Eduzyolo/PSE_project/SCHEMATIC/scheda PSE/libreria/3dmodels/DG126-5.0-xxP (pitch 5.0mm)/Demo-DG126.png

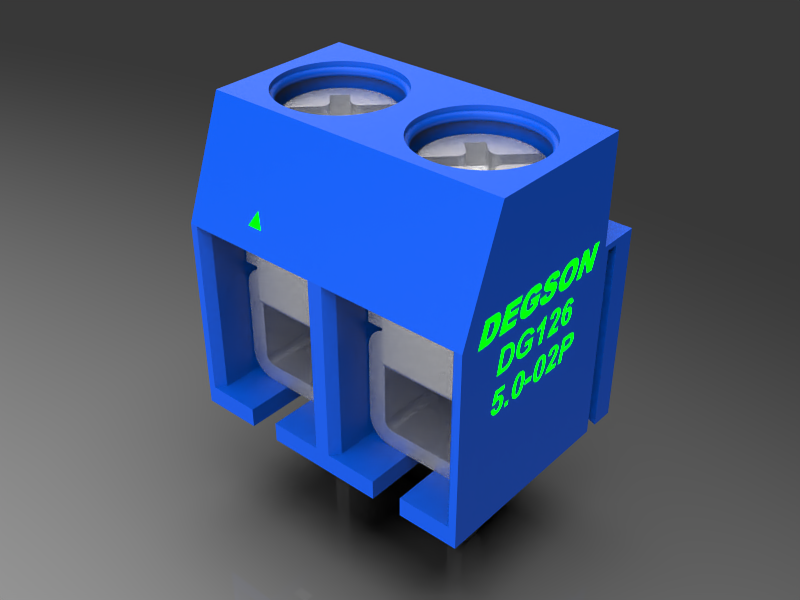
SCHEMATIC/scheda PSE/libreria/3dmodels/DG126-5.0-xxP (pitch 5.0mm)/Demo-DG126.png
