Eduzyolo/PSE_project/CASE/render/immagini scheda/immagine case_Gloss.png

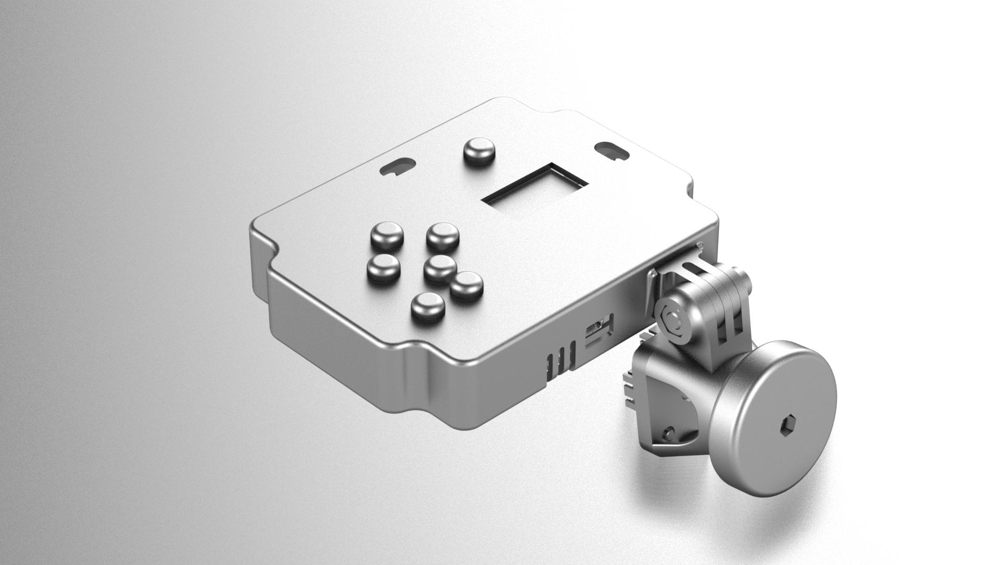
CASE/render/immagini scheda/immagine case_Gloss.png
