Eduzyolo/PSE_project/README.md

# PSE_project
This is the official repo for the PSE project 

# LICENSE
This repo is under CC BY-NC 4.0 license
