Eduzyolo/PSE_project/CASE/README.md

This folder contains the project for the CAD 3D
