Eduzyolo/PSE_project/CASE/stl per stampa del CASE e ENCODER/README.md

IMPOSTAZIONI E OGGETTI NECESSARI PER IL CASE
per un breve tutorial visitare la pagina:
https://floppylab.altervista.org/case-per-un-circuito/

IMPOSTAZIONI STAMPA (valide per tutte le parti):
 - materiale PLA
 - layer 0.2mm
 - riempimento 15%
 - 3 perimetri
 - skirt (facoltativo)
 - orientamento parte come da file
 - no supporti

 OGGETTI NECESSARI:
  - 1 vite M3 8mm (testa svasata)
  - 4 viti M3 10mm (testa svasata)
  - 7 viti M3 16mm (testa svasata)
  - molle Ø 4mm, Ø filo 0.2mm, lunghezza 5mm
  	- (quelle delle penne da scrivere vanno bene) -> da tagliare in pezzi lunghi 5mm circa
  - 5 inserti filettati in ottone M3 3mm
  - 30cm tubo in PVC trasparente Øext 6mm, Øint 4mm

OGGETTI FACOLTATIVI:
 - bomboletta spray nera (per l'interno del case)
 - bomboletta spray colore a scelta (per l'esterno del case)
