Eduzyolo/PSE_project/CASE/render/immagini scheda/immagine case.png

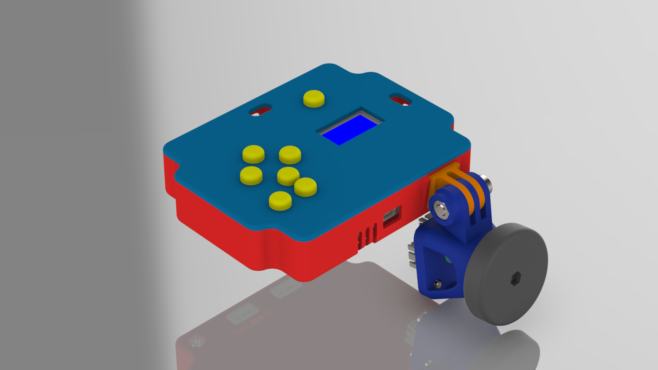
CASE/render/immagini scheda/immagine case.png
