Eduzyolo/PSE_project/CASE/render/immagini scheda/immagine case_Clown.png

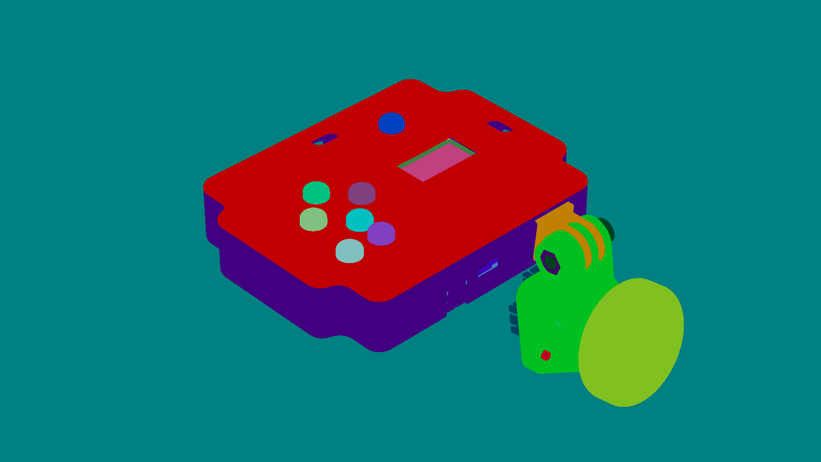
CASE/render/immagini scheda/immagine case_Clown.png
