Eduzyolo/PSE_project/CASE/render/immagini scheda/immagine case_Roughness.png

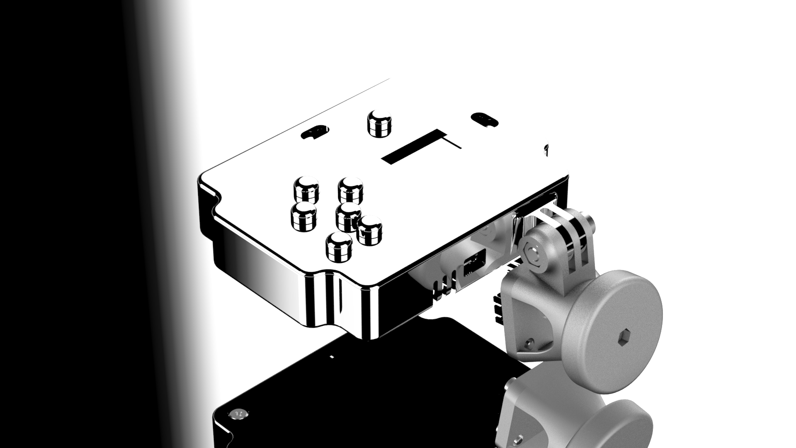
CASE/render/immagini scheda/immagine case_Roughness.png
