Eduzyolo/PSE_project/CASE/render/immagini scheda/render assieme esploso.JPG

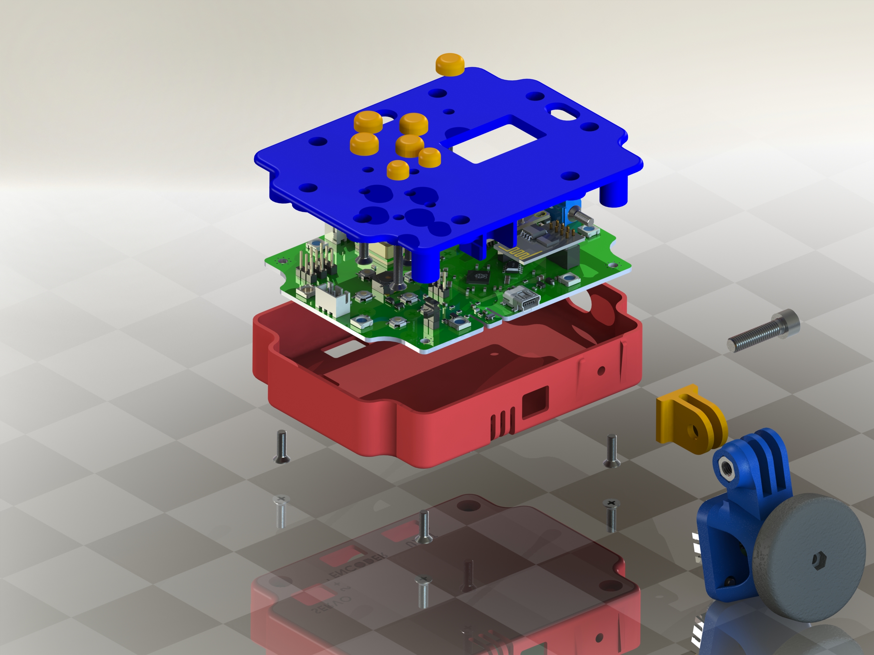
CASE/render/immagini scheda/render assieme esploso.JPG
