Eduzyolo/PSE_project/CASE/encoder magnetico/Assieme.SLDASM

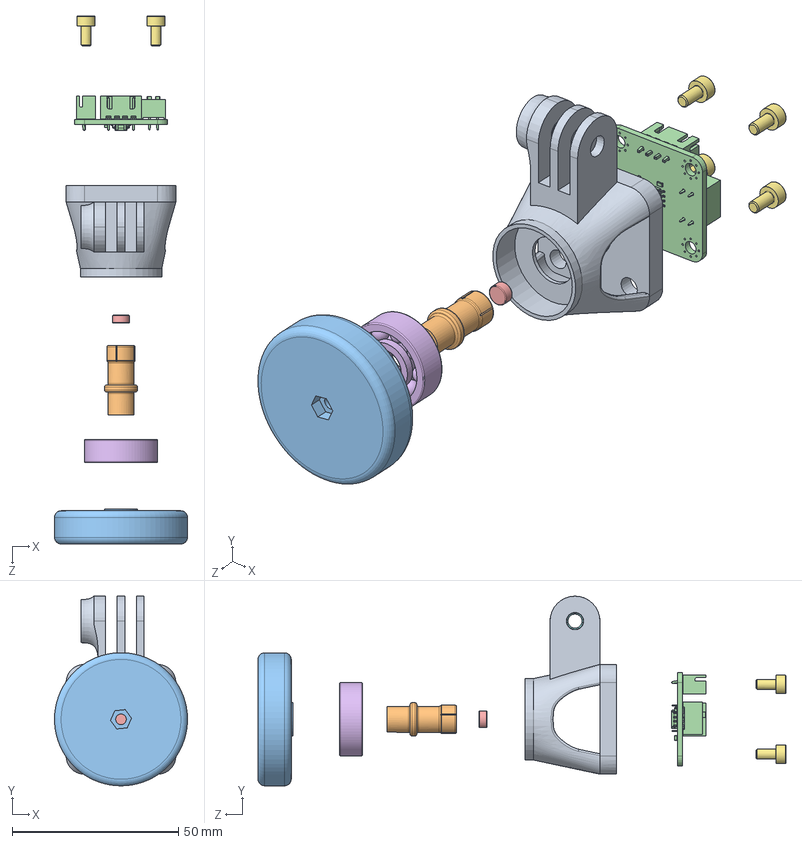
[picture p7: CAD file, 2023-06-22]
CASE/encoder magnetico/Assieme.SLDASM
40.0 x 57.0 x 158.7 mm
case encoder
perno sotto
ruota
PCB encoder
magnete
instrument ball bearing_68_iso
socket head cap screw_iso x 4
hex nut style 1 gradeab_iso
