Eduzyolo/PSE_project/CASE/case del prof/case grande PSE.dxf

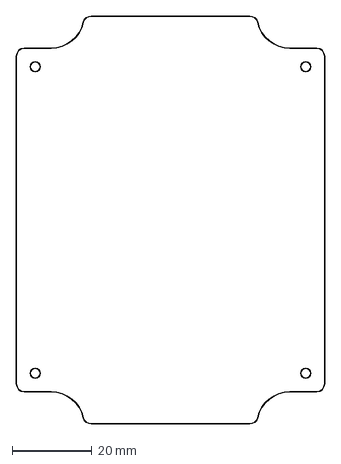
[picture p8: CAD file, 2023-04-04]
CASE/case del prof/case grande PSE.dxf
77.4 x 102.4 mm
