Eduzyolo/PSE_project/CASE/case scheda pse/coperchio.SLDPRT

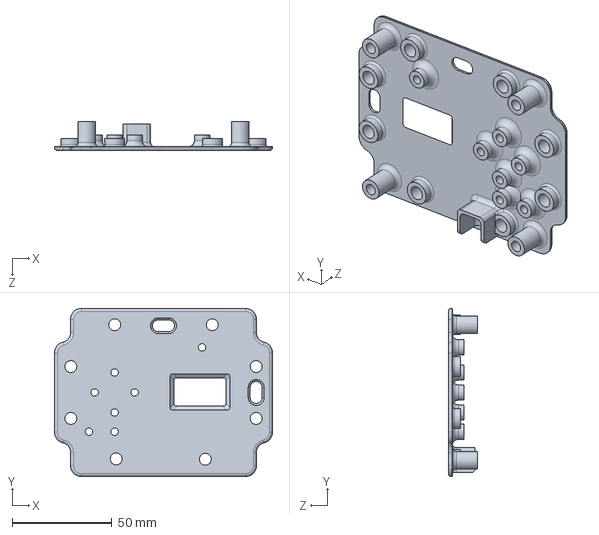
[picture p9: CAD file, 2023-06-22]
CASE/case scheda pse/coperchio.SLDPRT
109.4 x 84.4 x 14.8 mm
