Eduzyolo/PSE_project/CASE/case scheda pse/stl case e encoder/scheda PSE - attacco gopro senza vite.STL

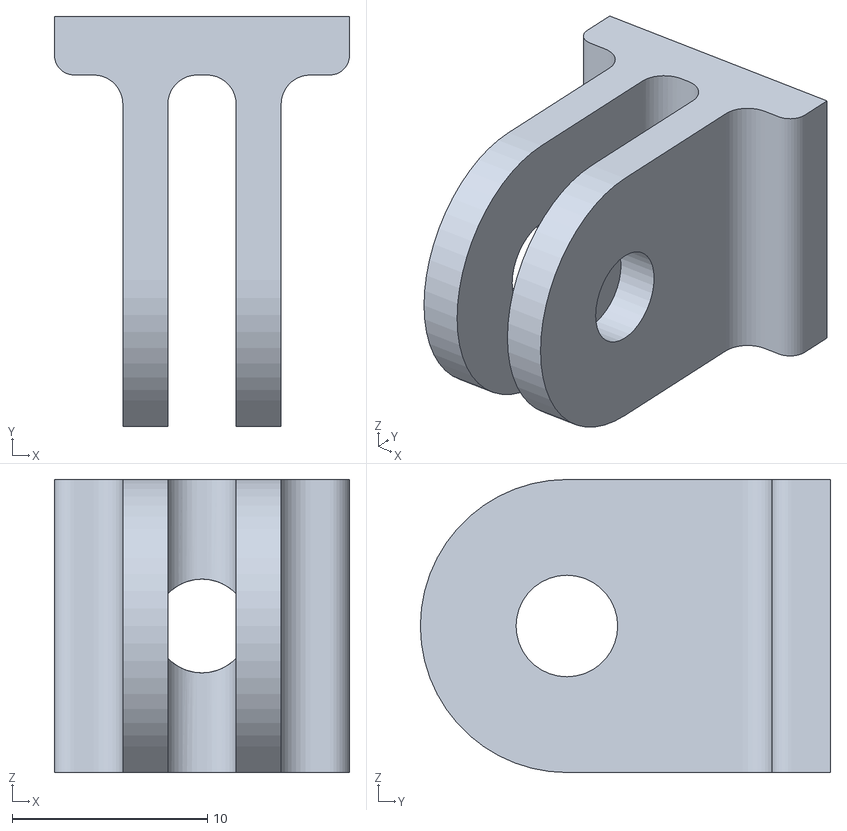
[picture p10: CAD file, 2023-06-18]
CASE/case scheda pse/stl case e encoder/scheda PSE - attacco gopro senza vite.STL
15.1 x 21.0 x 15.0
