Eduzyolo/PSE_project/CASE/stl per stampa del CASE e ENCODER/scheda PSE - bottoni 2.0.STL

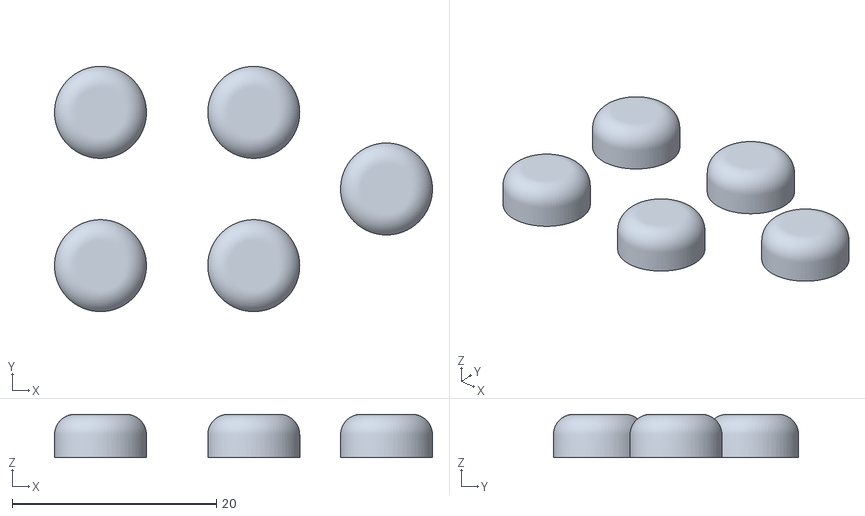
[picture p11: CAD file, 2023-06-18]
CASE/stl per stampa del CASE e ENCODER/scheda PSE - bottoni 2.0.STL
37.0 x 24.0 x 4.25
