Eduzyolo/PSE_project/SCHEMATIC/ENCODER/ENCODER.step

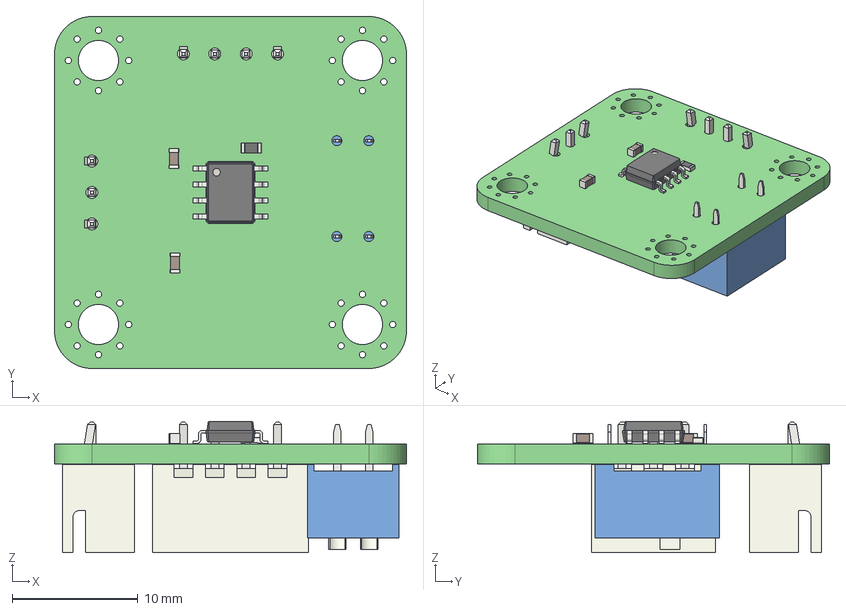
[picture p12: CAD file, 2023-04-01]
SCHEMATIC/ENCODER/ENCODER.step
28.0 x 28.0 x 10.4 mm
ENCODER PCB
