Eduzyolo/PSE_project/SCHEMATIC/scheda PSE/libreria/3dmodels/AKSCT-G-BLACK.stp

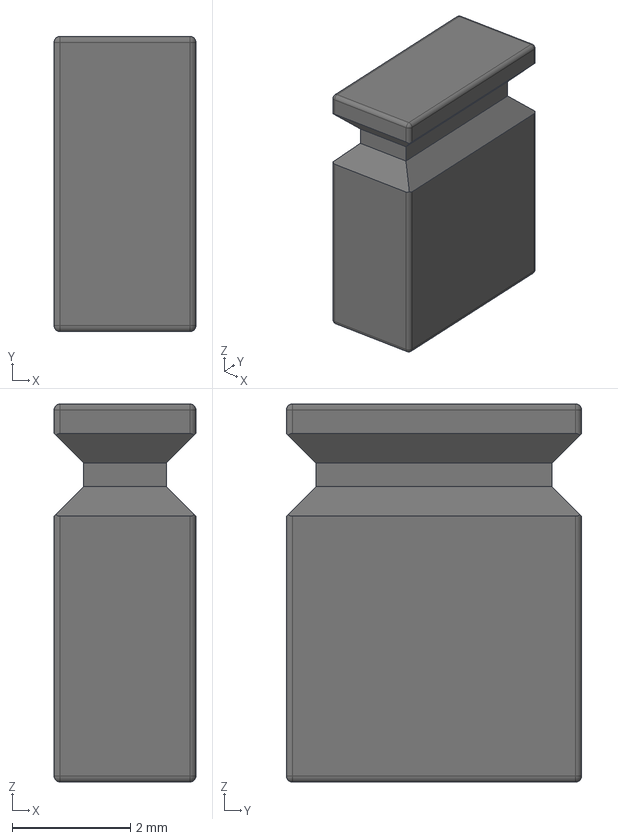
[picture p13: CAD file, 2023-04-17]
SCHEMATIC/scheda PSE/libreria/3dmodels/AKSCT-G-BLACK.stp
2.40 x 5.00 x 6.40 mm
