Eduzyolo/PSE_project/CASE/case del prof/RND 455-00210_3D.STEP

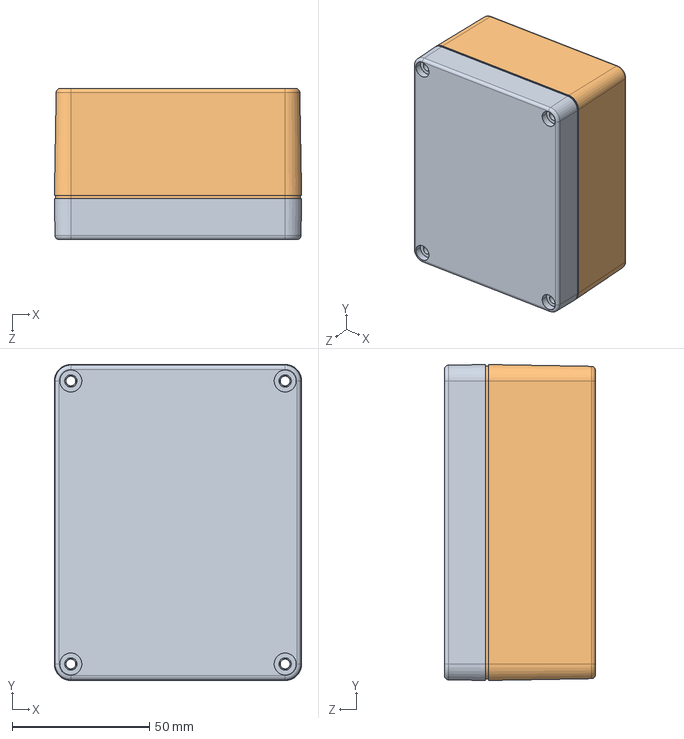
[picture p15: CAD file, 2023-04-04]
CASE/case del prof/RND 455-00210_3D.STEP
90.0 x 115.0 x 55.0 mm
