Eduzyolo/PSE_project/CASE/case scheda pse/botton 2.0 reset & boot.SLDPRT

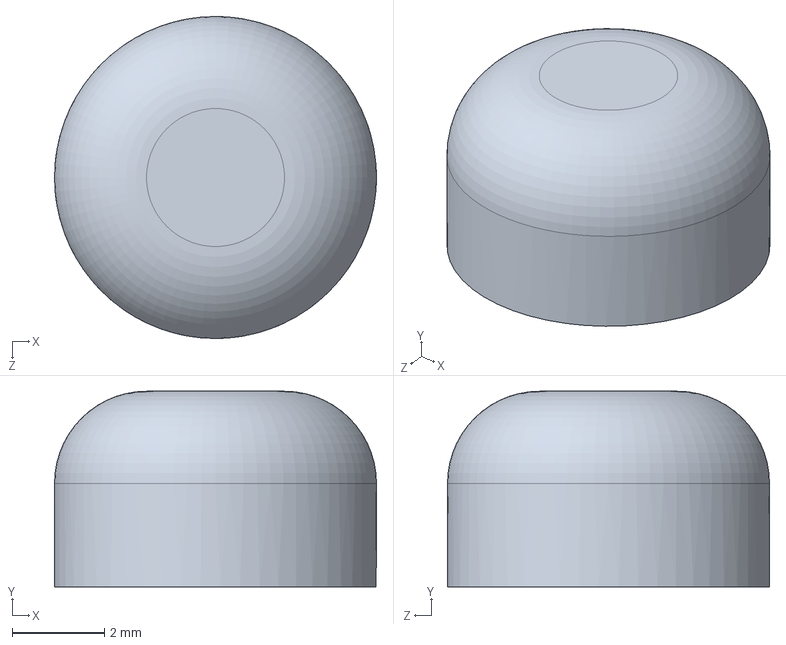
[picture p16: CAD file, 2023-06-22]
CASE/case scheda pse/botton 2.0 reset & boot.SLDPRT
7.00 x 4.25 x 7.00 mm
