Eduzyolo/PSE_project/CASE/case scheda pse/stl case e encoder/scheda PSE - case encoder.STL

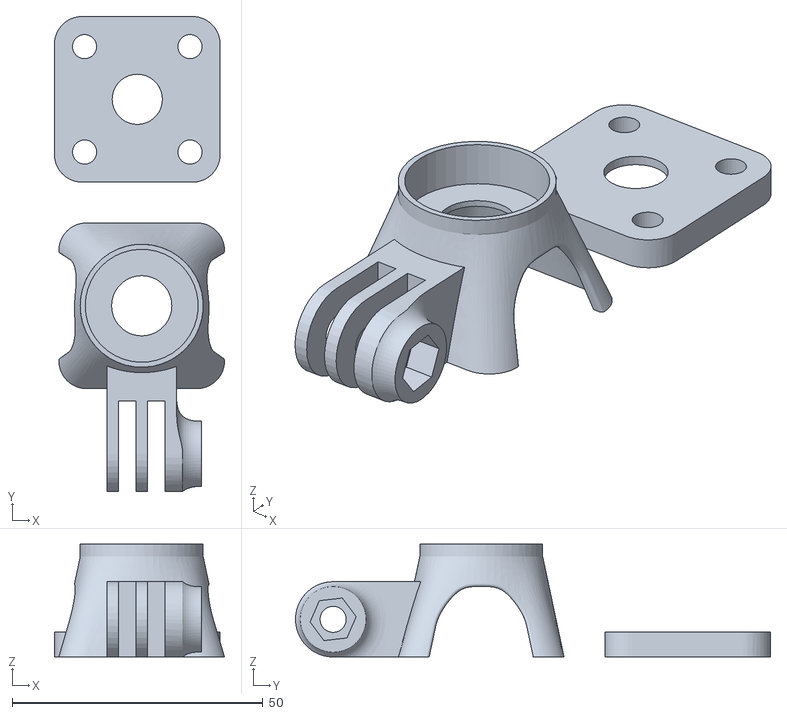
[picture p17: CAD file, 2023-06-18]
CASE/case scheda pse/stl case e encoder/scheda PSE - case encoder.STL
33.9 x 94.6 x 22.5
