Eduzyolo/PSE_project/CASE/encoder magnetico/case encoder.SLDPRT

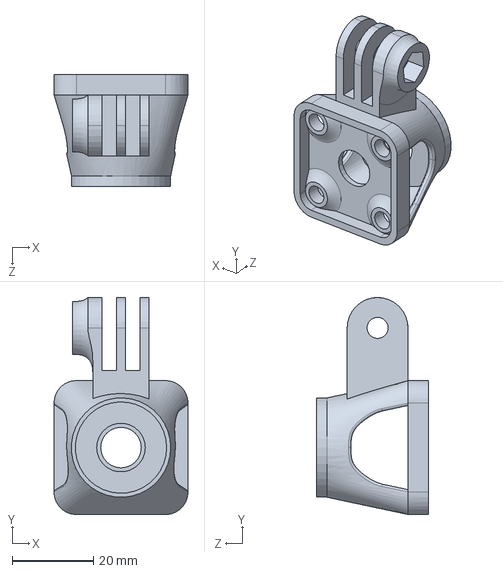
[picture p18: CAD file, 2023-06-18]
CASE/encoder magnetico/case encoder.SLDPRT
33.0 x 53.5 x 27.5 mm
