Eduzyolo/PSE_project/SCHEMATIC/scheda PSE/libreria/3dmodels/ESP8266-ESP01.STEP

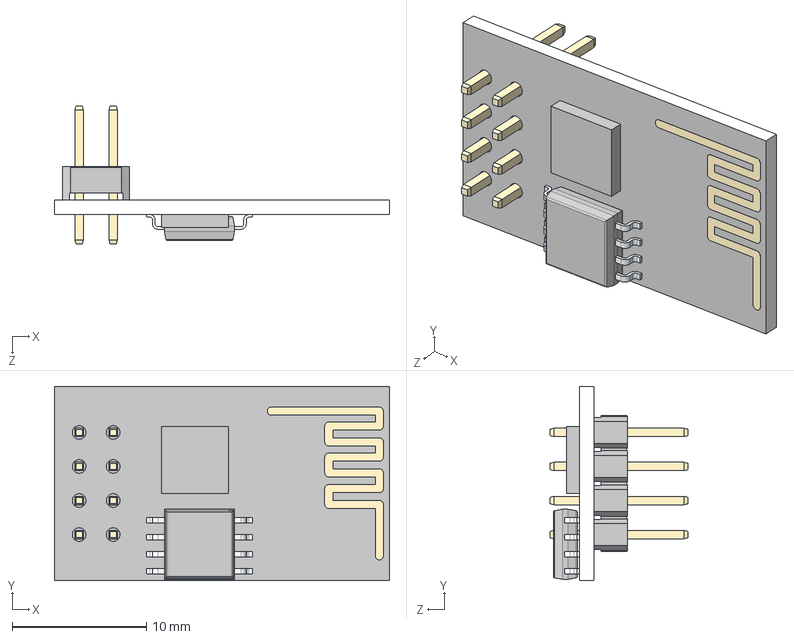
[picture p20: CAD file, 2023-04-17]
SCHEMATIC/scheda PSE/libreria/3dmodels/ESP8266-ESP01.STEP
25.0 x 14.5 x 10.3 mm
Platine.stp.STEP
PinSockel.stp.STEP
PCB_Antenna.stp.STEP
Pin_Stiftleiste.stp.STEP x 8
SerialFlashMem.stp.STEP
ESP8266EX.stp.STEP
