Eduzyolo/PSE_project/CASE/case scheda pse/botton 2.0.SLDPRT

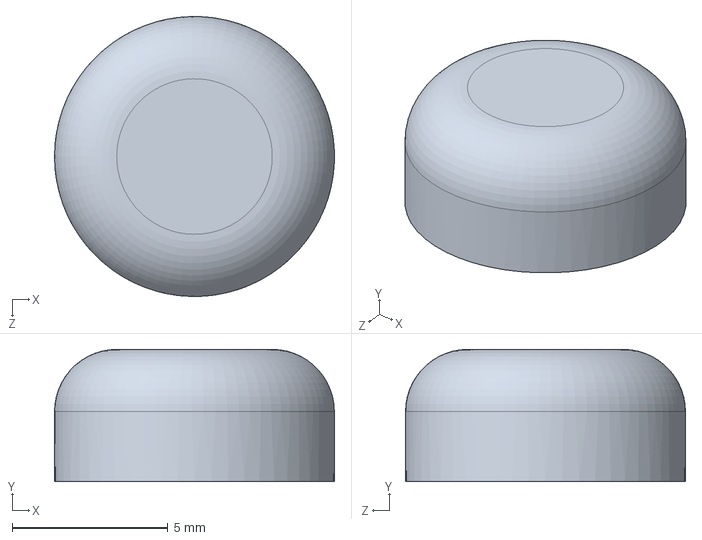
[picture p21: CAD file, 2023-06-22]
CASE/case scheda pse/botton 2.0.SLDPRT
9.00 x 4.25 x 9.00 mm
