Eduzyolo/PSE_project/CASE/case scheda pse/stl case e encoder/scheda PSE - ruota encoder.STL

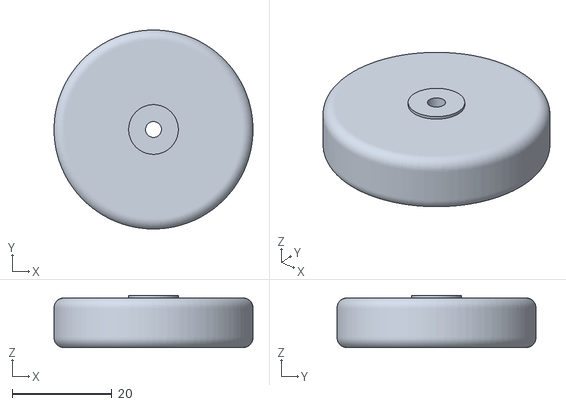
[picture p22: CAD file, 2023-06-18]
CASE/case scheda pse/stl case e encoder/scheda PSE - ruota encoder.STL
40.0 x 40.0 x 10.5
