Eduzyolo/PSE_project/CASE/encoder magnetico/perno sotto.SLDPRT

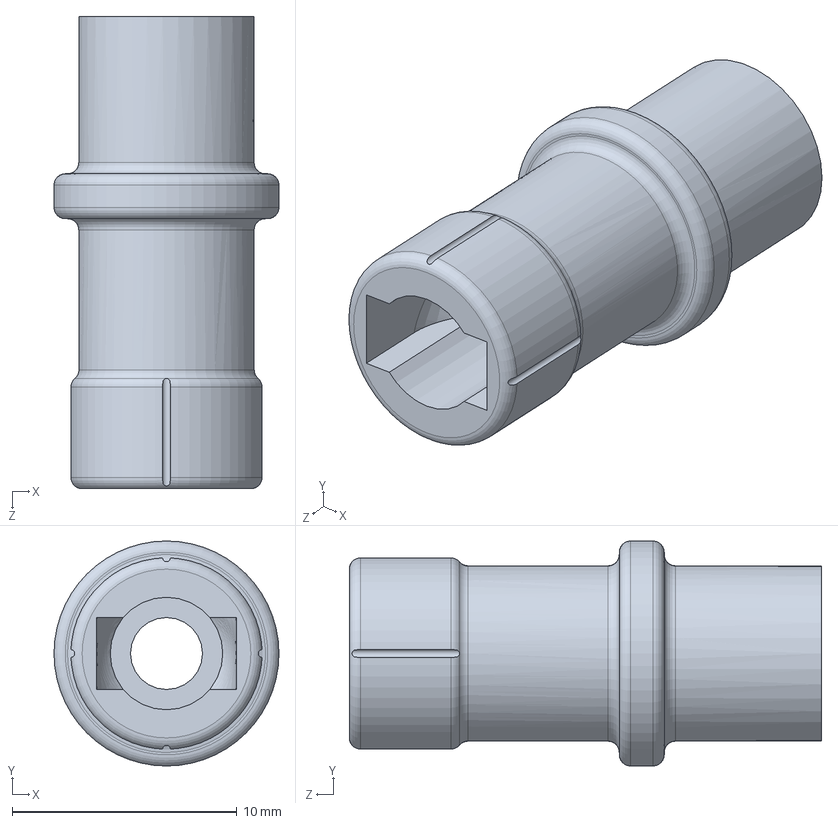
[picture p23: CAD file, 2023-06-15]
CASE/encoder magnetico/perno sotto.SLDPRT
10.0 x 10.0 x 21.0 mm
