Eduzyolo/PSE_project/CASE/stl per stampa del CASE e ENCODER/scheda PSE - bottoni 2.0 reset & boot.STL

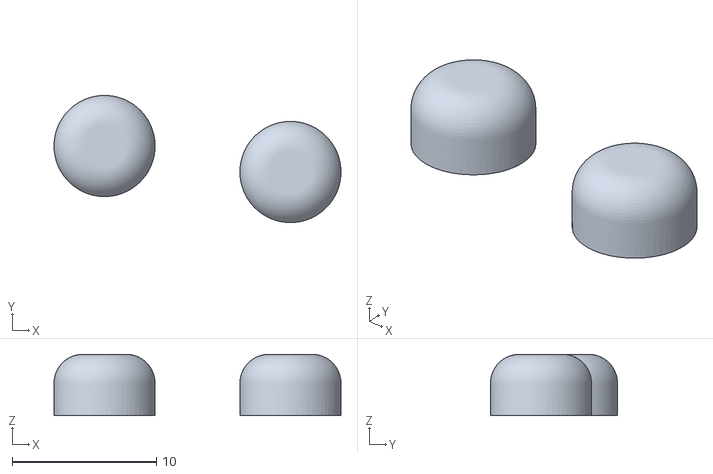
[picture p24: CAD file, 2023-06-18]
CASE/stl per stampa del CASE e ENCODER/scheda PSE - bottoni 2.0 reset & boot.STL
19.9 x 8.80 x 4.25
