Eduzyolo/PSE_project/SCHEMATIC/scheda PSE/libreria/3dmodels/MLT-8530.step

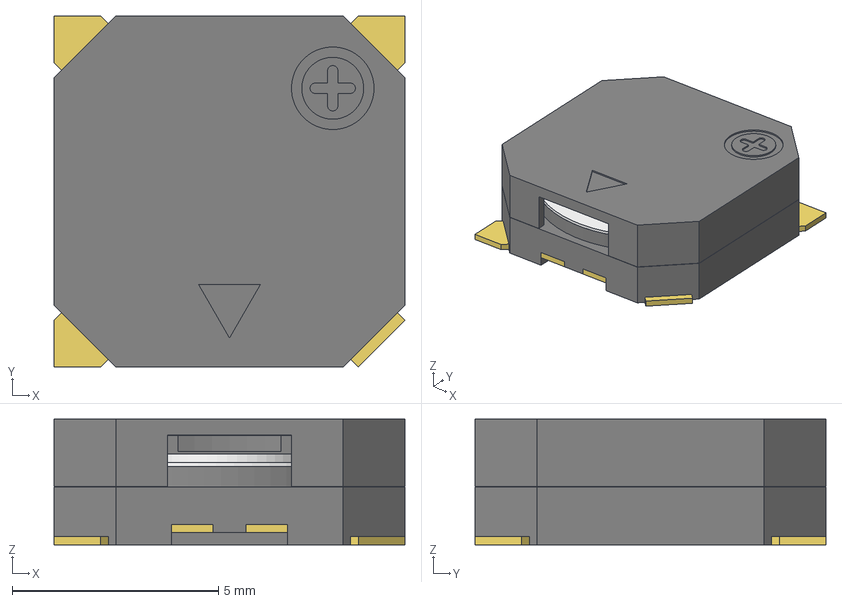
[picture p26: CAD file, 2023-04-14]
SCHEMATIC/scheda PSE/libreria/3dmodels/MLT-8530.step
8.50 x 8.50 x 3.05 mm
CaseBody
CoverBody
MembraneBody
Plate1Body
Plate2Body
Plate3Body
Plate4Body
Plate5Body
Plate6Body
Pin1Body
Pin2Body
Pin3Body
Pin4Body
