Eduzyolo/PSE_project/CASE/case scheda pse/case scheda PSE.SLDPRT

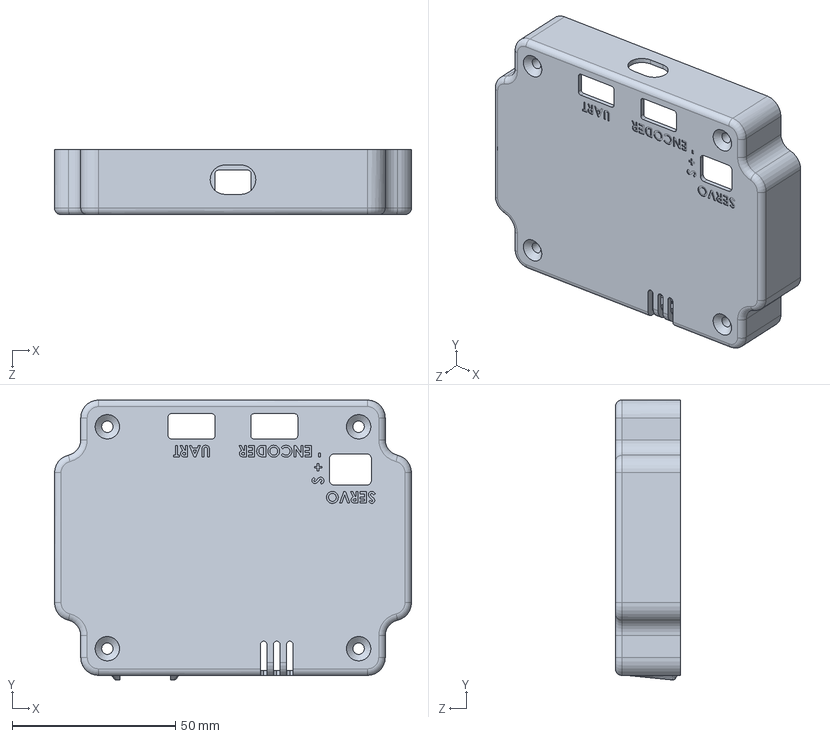
[picture p27: CAD file, 2023-06-18]
CASE/case scheda pse/case scheda PSE.SLDPRT
109.4 x 85.8 x 20.0 mm
