Eduzyolo/PSE_project/CASE/encoder magnetico/magnete.SLDPRT

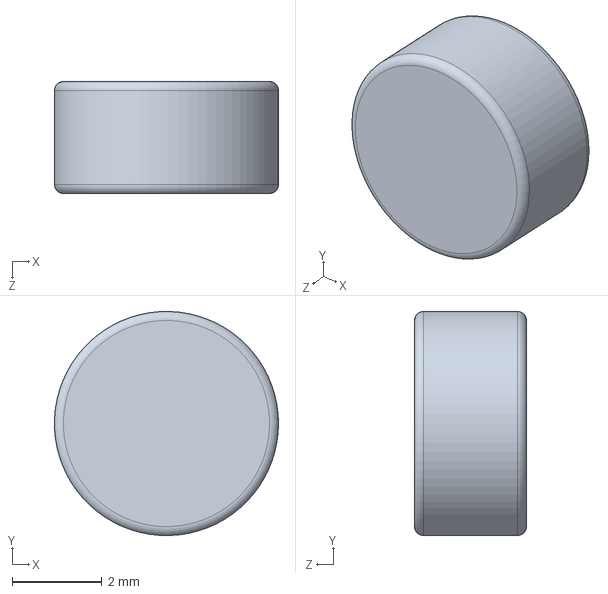
[picture p28: CAD file, 2023-04-17]
CASE/encoder magnetico/magnete.SLDPRT
5.00 x 5.00 x 2.50 mm
