Eduzyolo/PSE_project/SCHEMATIC/scheda PSE/libreria/3dmodels/DG126-5.0-xxP (pitch 5.0mm)/DG126-5.0-03P-12-00AH.STEP

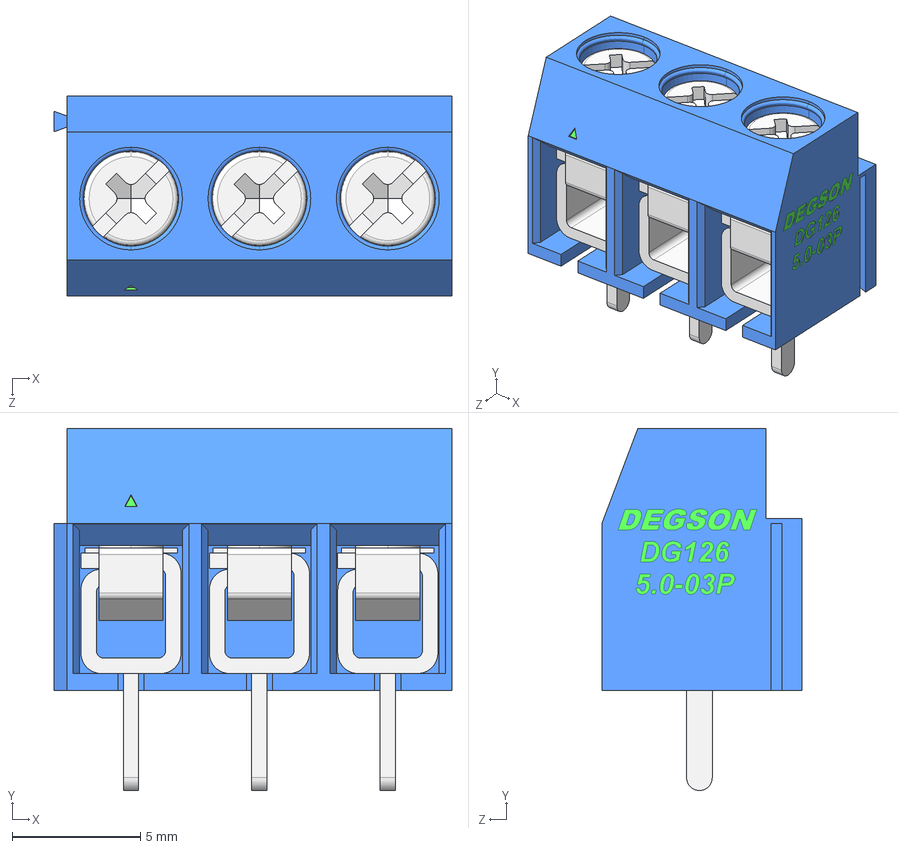
[picture p29: CAD file, 2023-03-30]
SCHEMATIC/scheda PSE/libreria/3dmodels/DG126-5.0-xxP (pitch 5.0mm)/DG126-5.0-03P-12-00AH.STEP
15.5 x 14.1 x 7.80 mm
