Eduzyolo/PSE_project/SCHEMATIC/scheda PSE/libreria/3dmodels/IND_IHLP-1212BZ_VIS.step

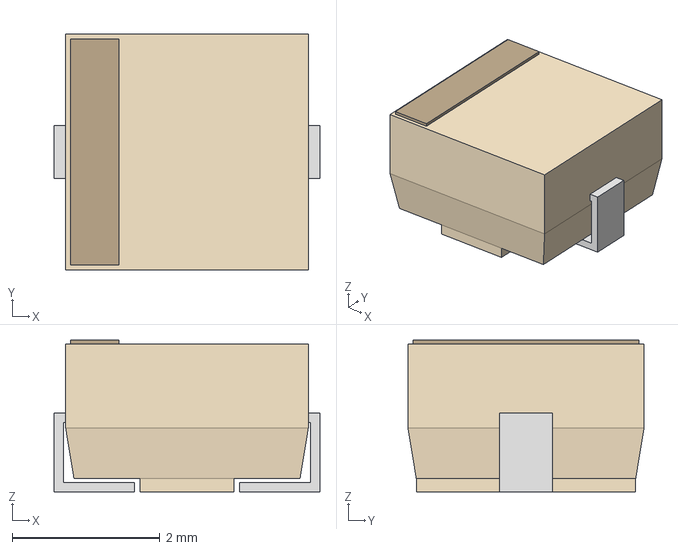
[picture p30: CAD file, 2023-04-04]
SCHEMATIC/scheda PSE/libreria/3dmodels/IND_IHLP-1212BZ_VIS.step
3.61 x 3.20 x 2.06 mm
