Eduzyolo/PSE_project/CASE/case scheda pse/pulsante.SLDPRT

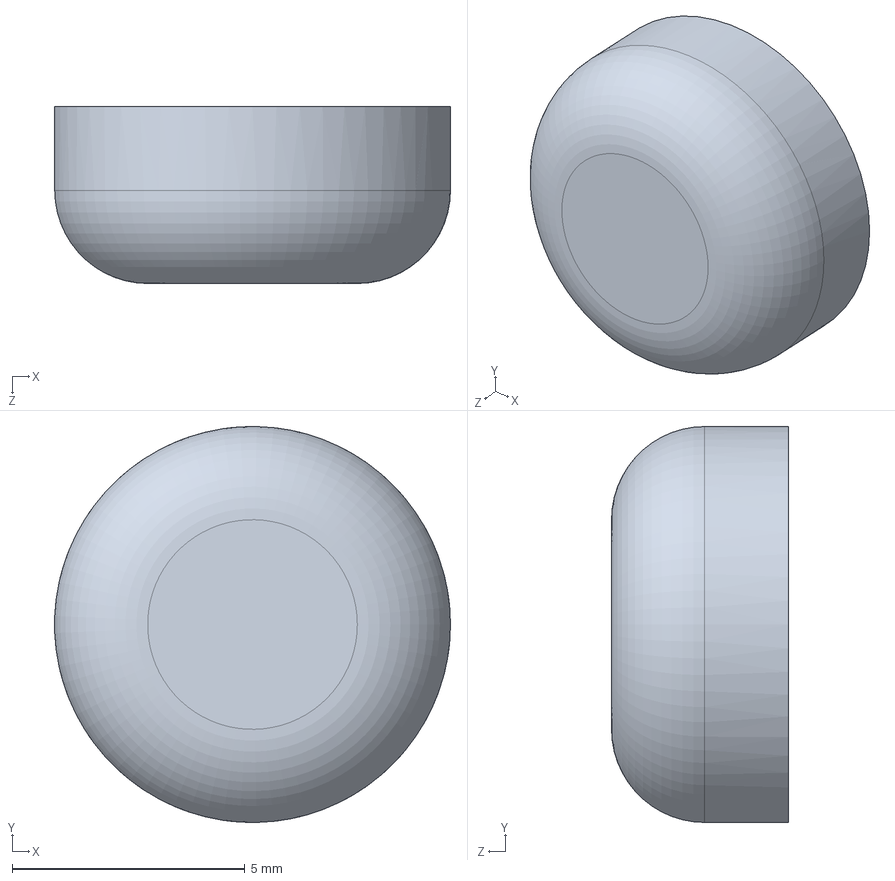
[picture p31: CAD file, 2023-06-18]
CASE/case scheda pse/pulsante.SLDPRT
8.50 x 8.50 x 3.80 mm
