Eduzyolo/PSE_project/SCHEMATIC/scheda PSE/libreria/3dmodels/Pantalla OLED 0.96'' 128x64.stp

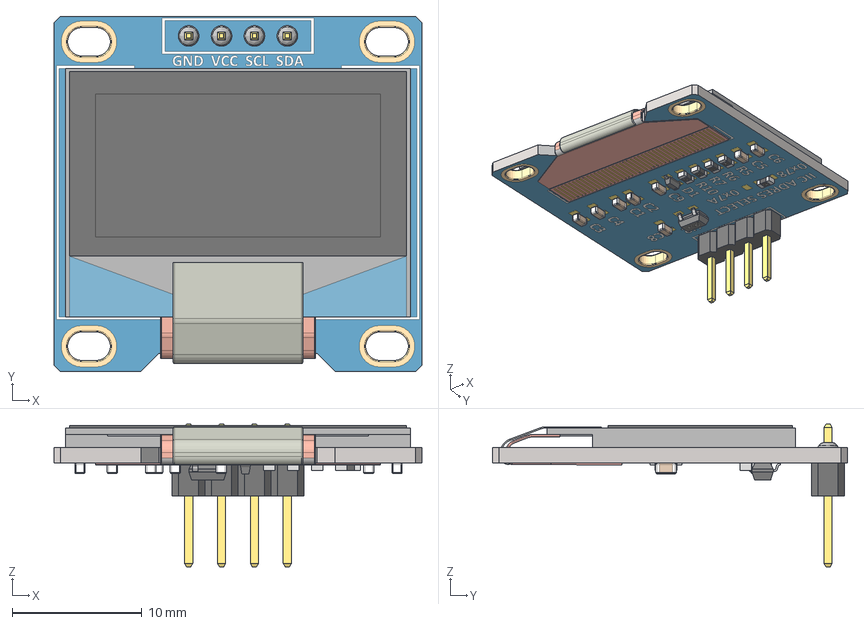
[picture p33: CAD file, 2023-04-04]
SCHEMATIC/scheda PSE/libreria/3dmodels/Pantalla OLED 0.96'' 128x64.stp
28.4 x 27.4 x 11.0 mm
SOT-23_TOR
RES_CR16_MTK_1 x 4
RES_CR16_MTK
SOD323F_DIO
