Eduzyolo/PSE_project/CASE/case scheda pse/cappuccio bottone.SLDPRT

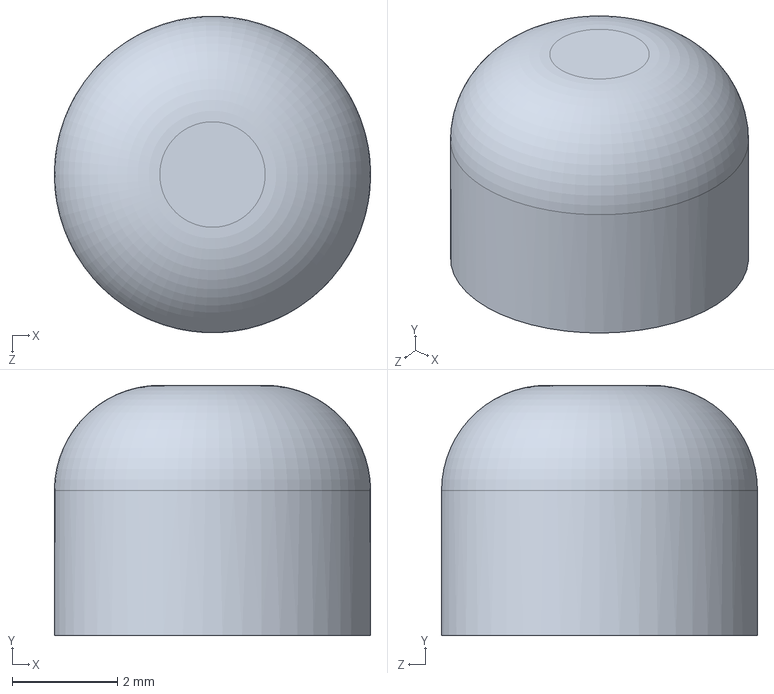
[picture p34: CAD file, 2023-06-18]
CASE/case scheda pse/cappuccio bottone.SLDPRT
6.00 x 4.75 x 5.99 mm
