Eduzyolo/PSE_project/CASE/encoder magnetico/ruota.SLDPRT

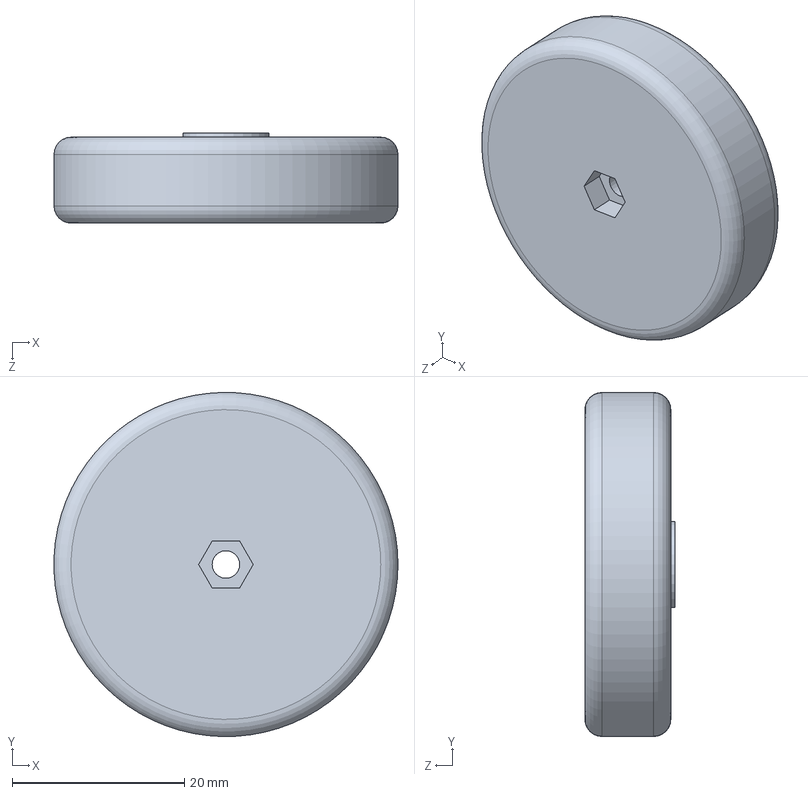
[picture p35: CAD file, 2023-04-01]
CASE/encoder magnetico/ruota.SLDPRT
40.0 x 40.0 x 10.5 mm
