Eduzyolo/PSE_project/SCHEMATIC/scheda PSE/libreria/3dmodels/usb mini.STEP

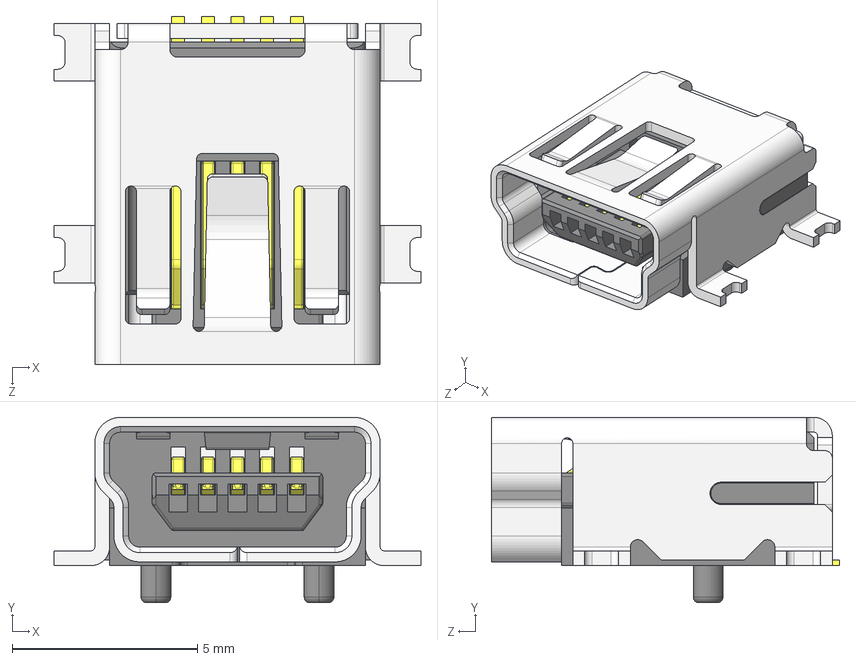
[picture p37: CAD file, 2023-04-04]
SCHEMATIC/scheda PSE/libreria/3dmodels/usb mini.STEP
9.90 x 5.00 x 9.40 mm
Case^GCT
Insert^GCT
Pin^GCT x 5
