Eduzyolo/PSE_project/SCHEMATIC/scheda PSE/libreria/3dmodels/TEMT6000X01.stp

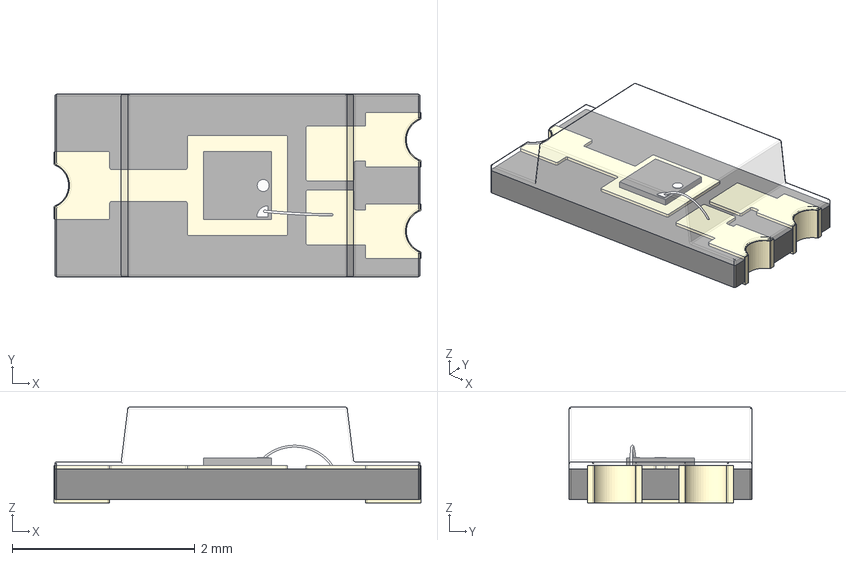
[picture p38: CAD file, 2023-03-30]
SCHEMATIC/scheda PSE/libreria/3dmodels/TEMT6000X01.stp
4.02 x 2.00 x 1.05 mm
