Eduzyolo/PSE_project/CASE/stl per stampa del CASE e ENCODER/scheda PSE - tappo foro led (con tubo).stl

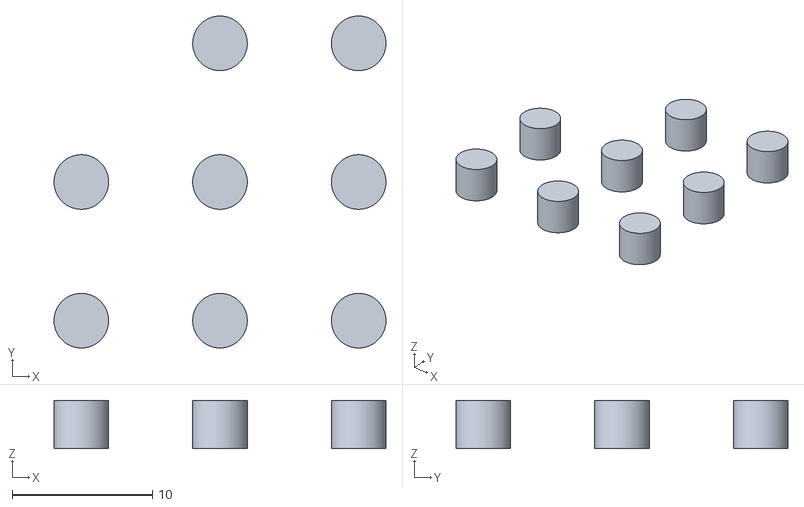
[picture p39: CAD file, 2023-06-18]
CASE/stl per stampa del CASE e ENCODER/scheda PSE - tappo foro led (con tubo).stl
23.7 x 23.7 x 3.46
