Eduzyolo/PSE_project/SCHEMATIC/scheda PSE/libreria/3dmodels/HF49FD.IGS

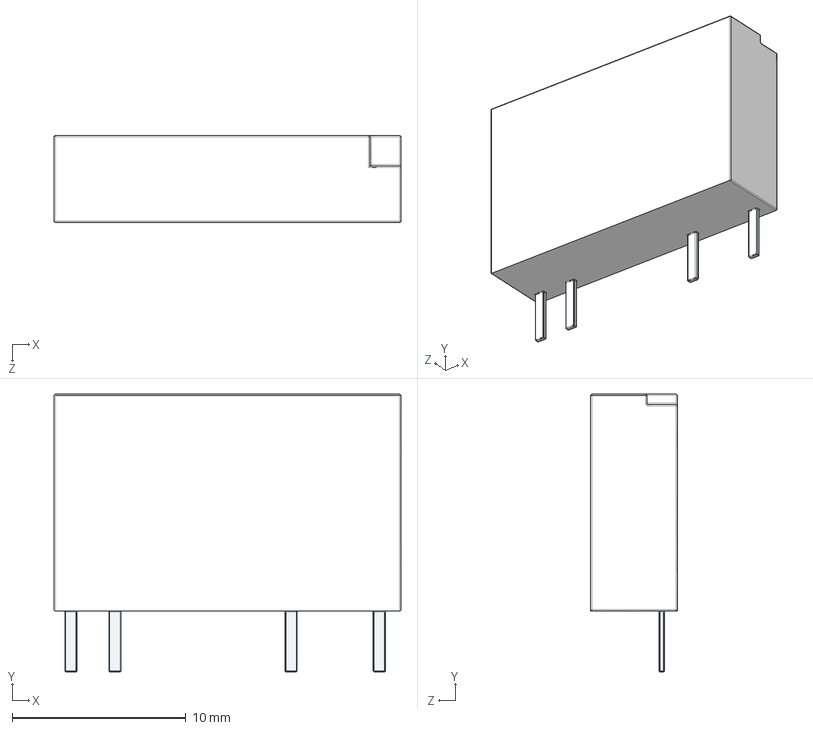
[picture p40: CAD file, 2023-03-30]
SCHEMATIC/scheda PSE/libreria/3dmodels/HF49FD.IGS
20.0 x 16.0 x 5.00 mm
