Eduzyolo/PSE_project/SCHEMATIC/scheda PSE/libreria/3dmodels/usb-c.STEP

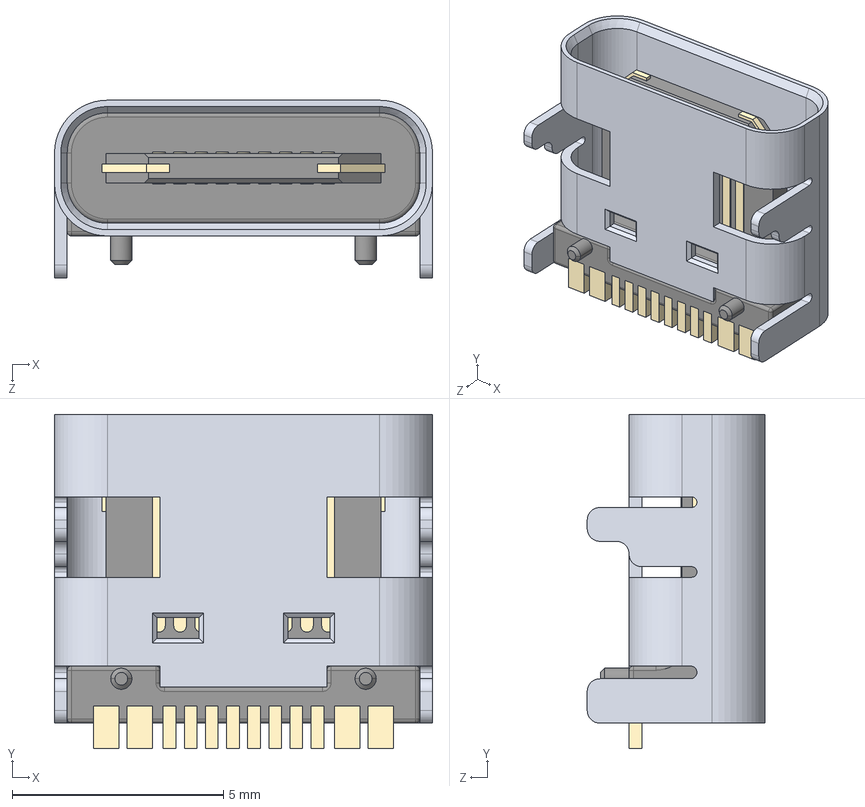
[picture p41: CAD file, 2023-03-30]
SCHEMATIC/scheda PSE/libreria/3dmodels/usb-c.STEP
8.94 x 7.90 x 4.20 mm
