Eduzyolo/PSE_project/SCHEMATIC/scheda PSE/libreria/3dmodels/GPS_sam-m8q.STEP

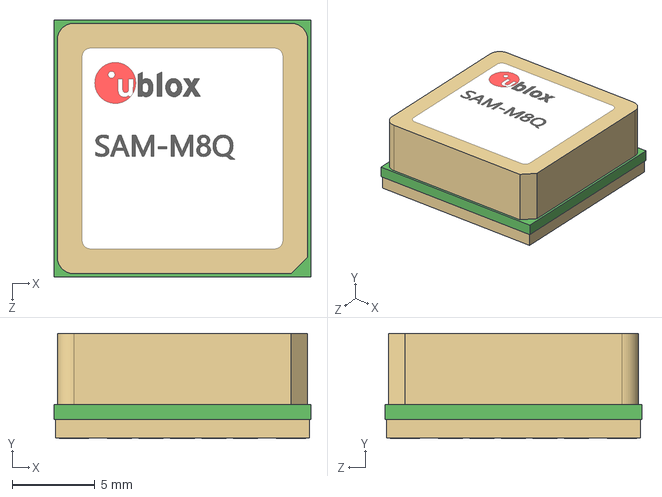
[picture p42: CAD file, 2023-03-30]
SCHEMATIC/scheda PSE/libreria/3dmodels/GPS_sam-m8q.STEP
15.5 x 6.35 x 15.5 mm
