Eduzyolo/PSE_project/SCHEMATIC/scheda PSE/libreria/3dmodels/HLK-2Mxx.step

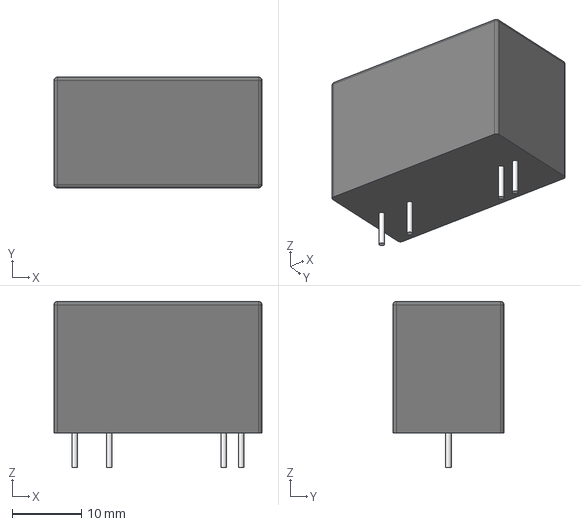
[picture p43: CAD file, 2023-03-30]
SCHEMATIC/scheda PSE/libreria/3dmodels/HLK-2Mxx.step
30.0 x 16.0 x 24.0 mm
