Eduzyolo/PSE_project/SCHEMATIC/scheda PSE/libreria/3dmodels/SOP-8.STEP

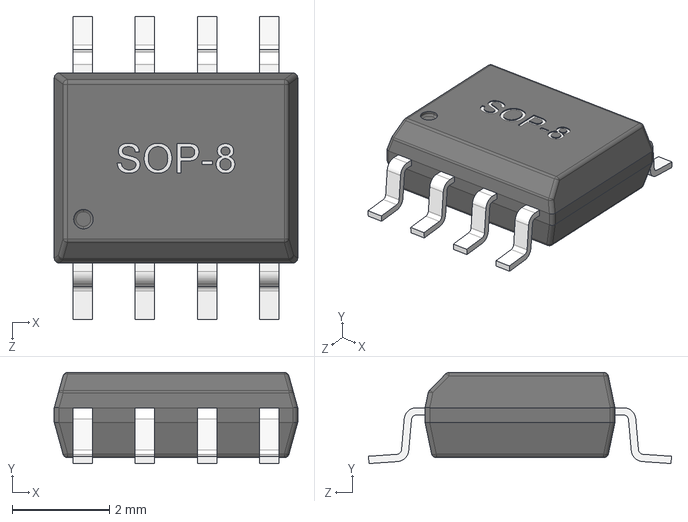
[picture p44: CAD file, 2023-03-30]
SCHEMATIC/scheda PSE/libreria/3dmodels/SOP-8.STEP
5.00 x 1.87 x 6.22 mm
