Eduzyolo/PSE_project/SCHEMATIC/scheda PSE/libreria/3dmodels/MAX6675.step

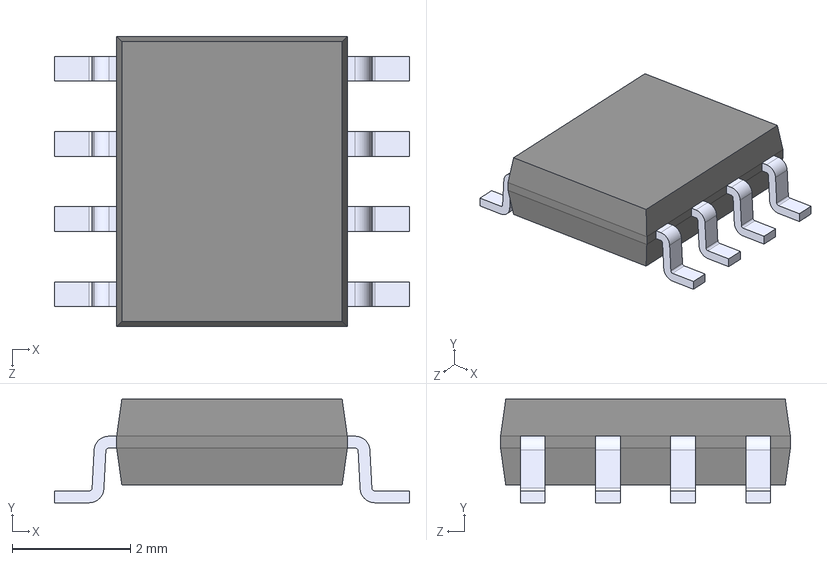
[picture p45: CAD file, 2023-03-30]
SCHEMATIC/scheda PSE/libreria/3dmodels/MAX6675.step
6.00 x 1.75 x 4.90 mm
