Eduzyolo/PSE_project/SCHEMATIC/scheda PSE/libreria/3dmodels/smd button.step

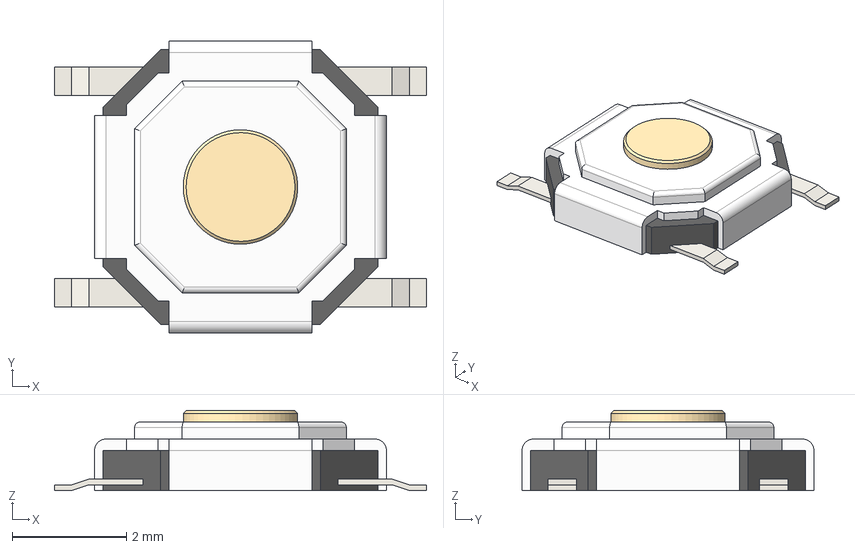
[picture p46: CAD file, 2023-03-30]
SCHEMATIC/scheda PSE/libreria/3dmodels/smd button.step
6.50 x 5.10 x 1.40 mm
