Eduzyolo/PSE_project/SCHEMATIC/scheda PSE/libreria/3dmodels/SMDRI127-150MT.STEP

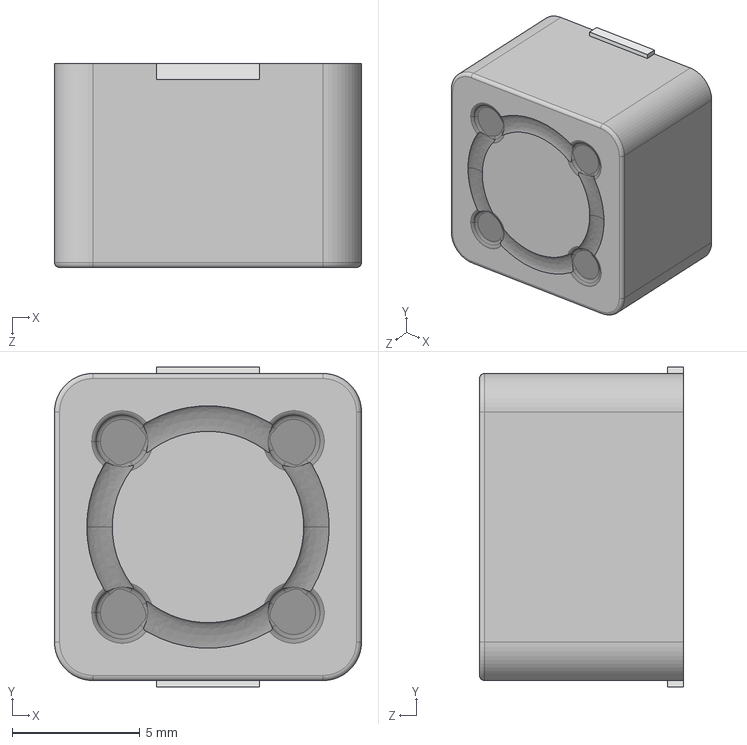
[picture p47: CAD file, 2023-03-30]
SCHEMATIC/scheda PSE/libreria/3dmodels/SMDRI127-150MT.STEP
12.0 x 12.5 x 8.00 mm
