Eduzyolo/PSE_project/SCHEMATIC/scheda PSE/libreria/3dmodels/MMA8451Q.STEP

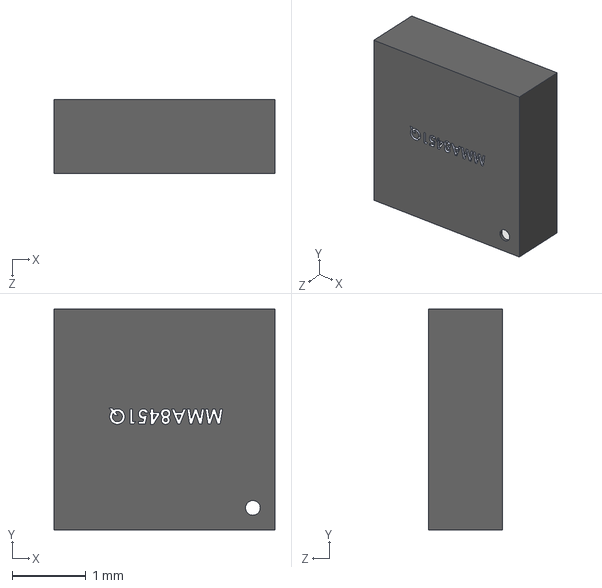
[picture p48: CAD file, 2023-03-30]
SCHEMATIC/scheda PSE/libreria/3dmodels/MMA8451Q.STEP
3.00 x 3.00 x 1.00 mm
