Eduzyolo/PSE_project/SCHEMATIC/scheda PSE/libreria/3dmodels/RP2040_QFN_PACKAGE.STEP

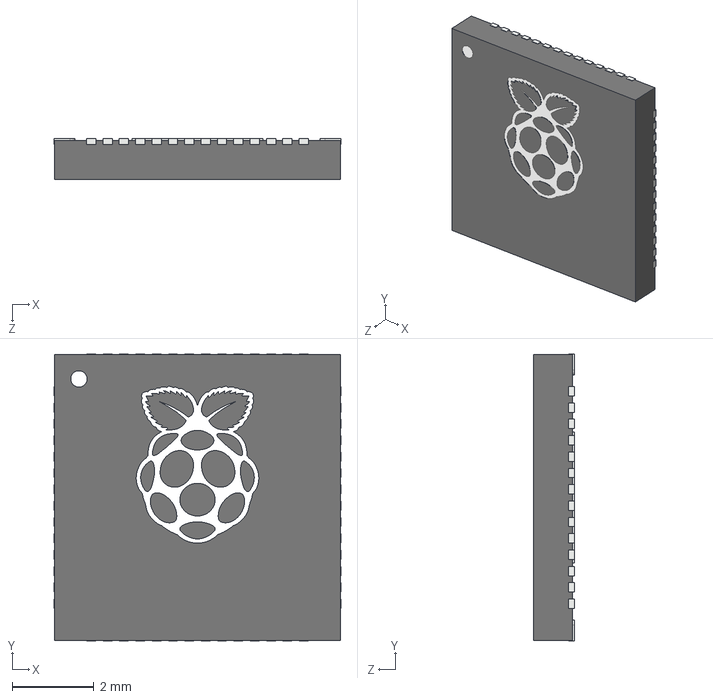
[picture p49: CAD file, 2023-03-30]
SCHEMATIC/scheda PSE/libreria/3dmodels/RP2040_QFN_PACKAGE.STEP
7.02 x 7.02 x 1.00 mm
