Eduzyolo/PSE_project/(list of files, cad)

Other CAD files:
CASE/stl per stampa del CASE e ENCODER/scheda PSE - coperchio.STL
CASE/case scheda pse/stl case e encoder/scheda PSE - perno encoder.STL
CASE/encoder magnetico/PCB encoder.SLDPRT
CASE/stl per stampa del CASE e ENCODER/scheda PSE - case scheda PSE.STL
CASE/stl per stampa del CASE e ENCODER/scheda PSE - case encoder.STL
CASE/case scheda pse/attacco gopro senza vite.SLDPRT
CASE/stl per stampa del CASE e ENCODER/scheda PSE - perno encoder.STL
CASE/case del prof/RND 455-00210_3D.SLDPRT
SCHEMATIC/scheda PSE/libreria/3dmodels/ESP8266-ESP01.SLDASM
SCHEMATIC/scheda PSE/libreria/3dmodels/MMA8451Q.SLDPRT
SCHEMATIC/scheda PSE/libreria/3dmodels/SMDRI127-150MT.SLDPRT
