Eduzyolo/PSE_project/(threads)

Thread 20 (2023-05-04):

Fixes on tests

Eduzyolo, 2023-05-04:
Compile:
- [x] Buzzer
- [x] temperature
- [x] accelerometer
- [x] Leds
- [x] GPS
- [ ] Eeprom
- [x] Oled
- [x] Encoder
- [x] Buttons

Work in real:
- [x] Buzzer
- [ ] temperature
- [ ] accelerometer
- [x] Leds
- [ ] GPS
- [ ] Eeprom
- [ ] Oled
- [ ] Encoder
- [ ] Buttons

Closed 2023-06-27.
