Eduzyolo/PSE_project/SCHEMATIC/PDF SCHEMATICI/schema ENCODER.pdf

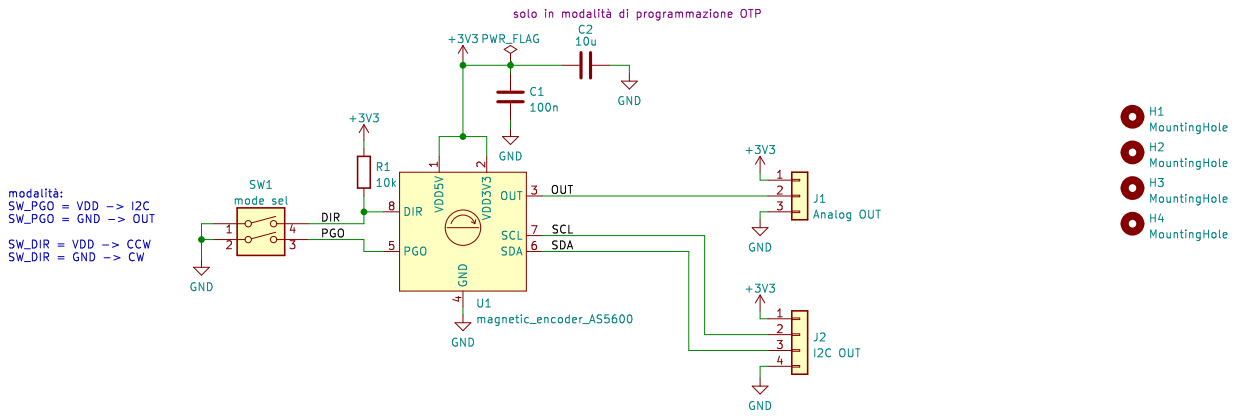
[picture p50: page 1]
