Eduzyolo/PSE_project/SCHEMATIC/PDF SCHEMATICI/schema SCHEDA PSE.pdf

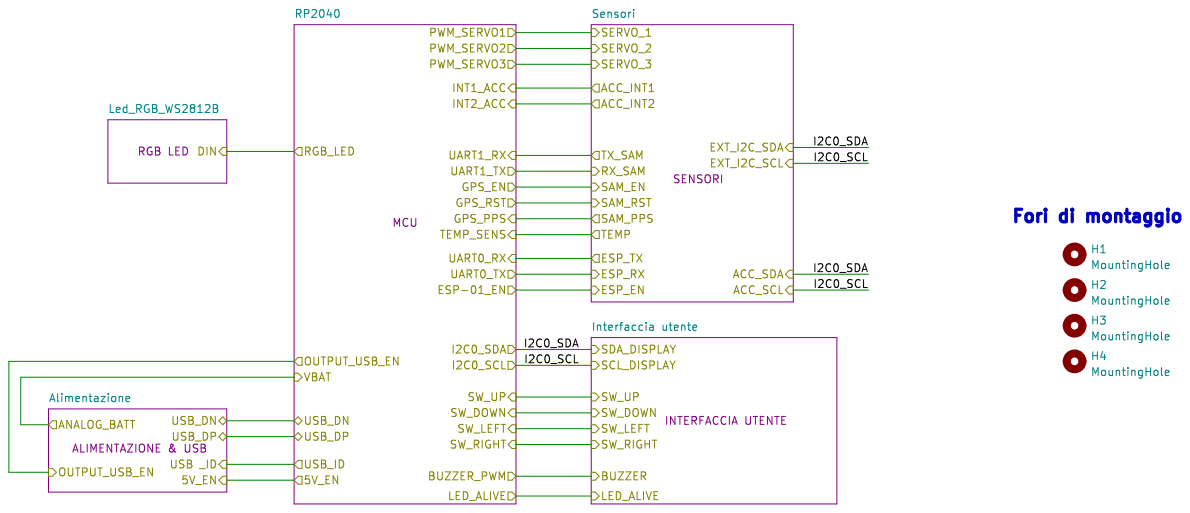
[picture p51: page 1]

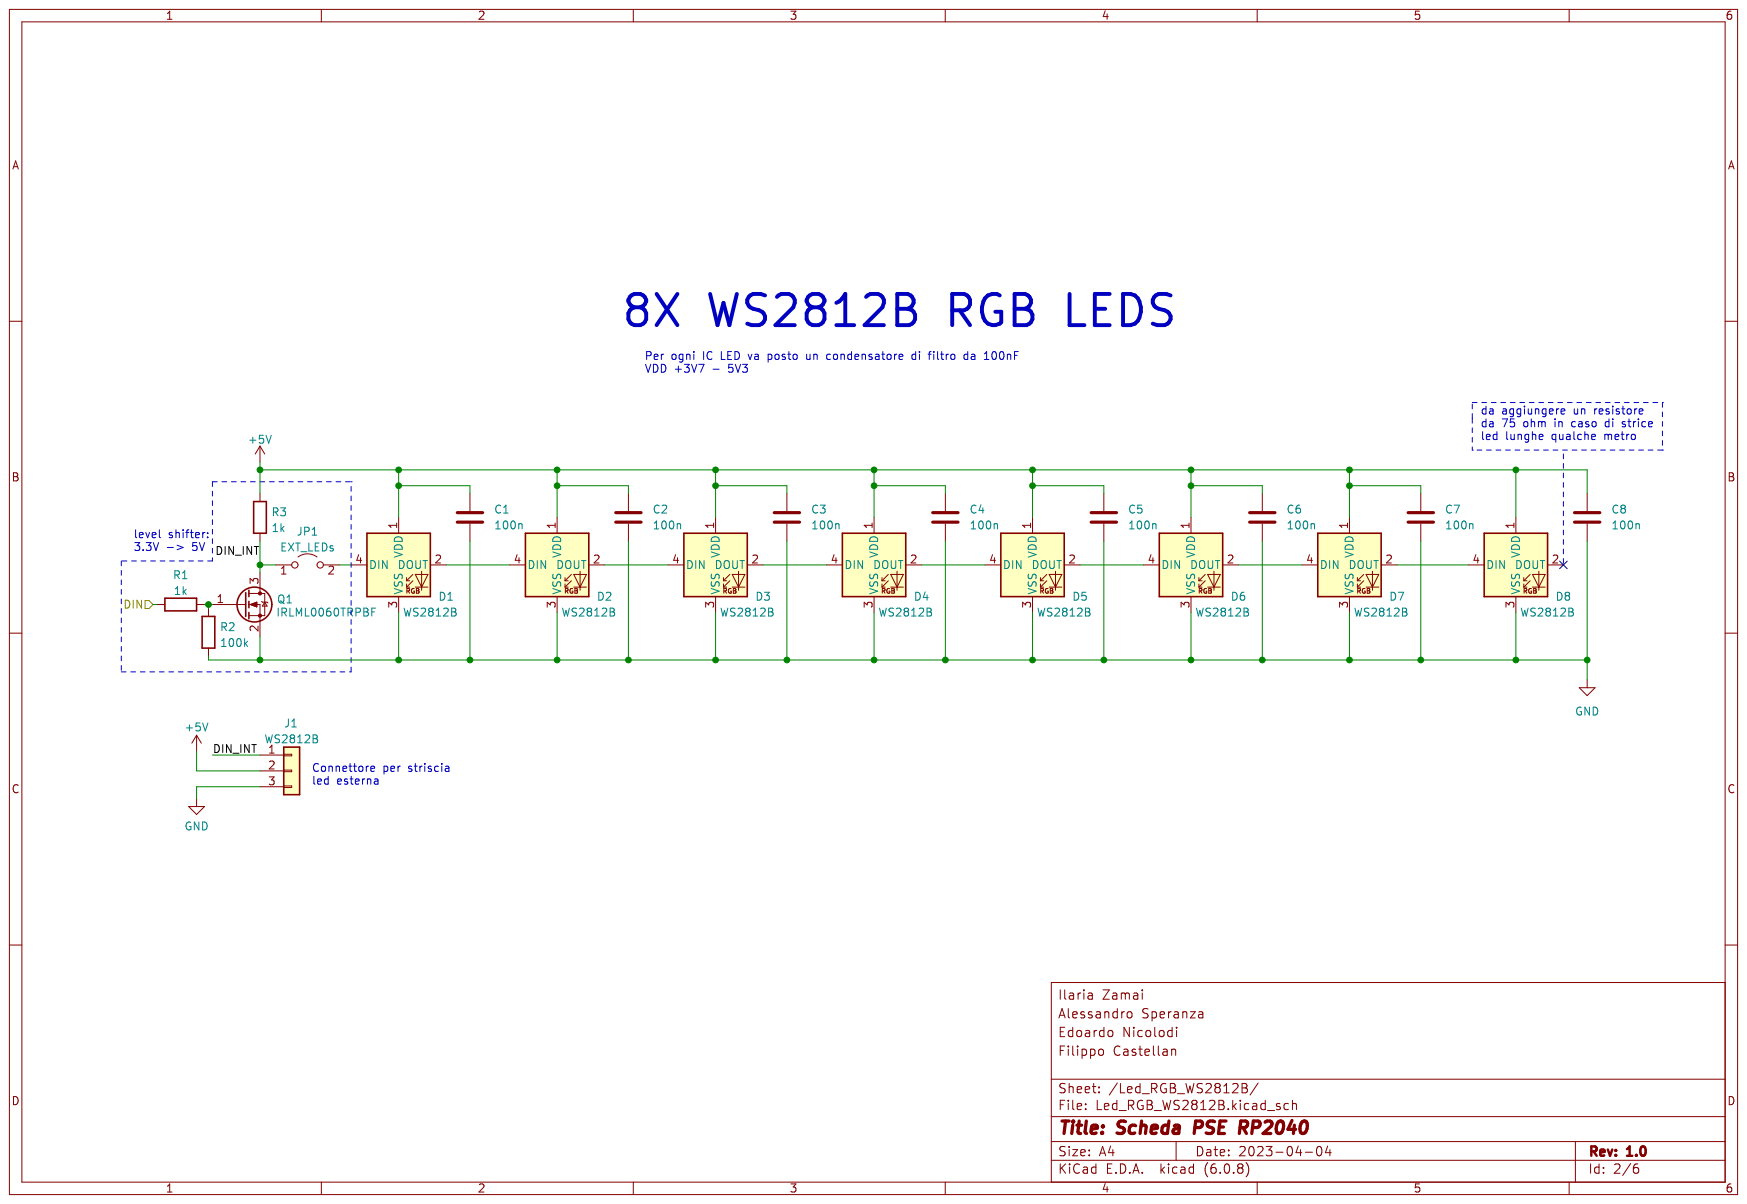
[picture p52: page 2]

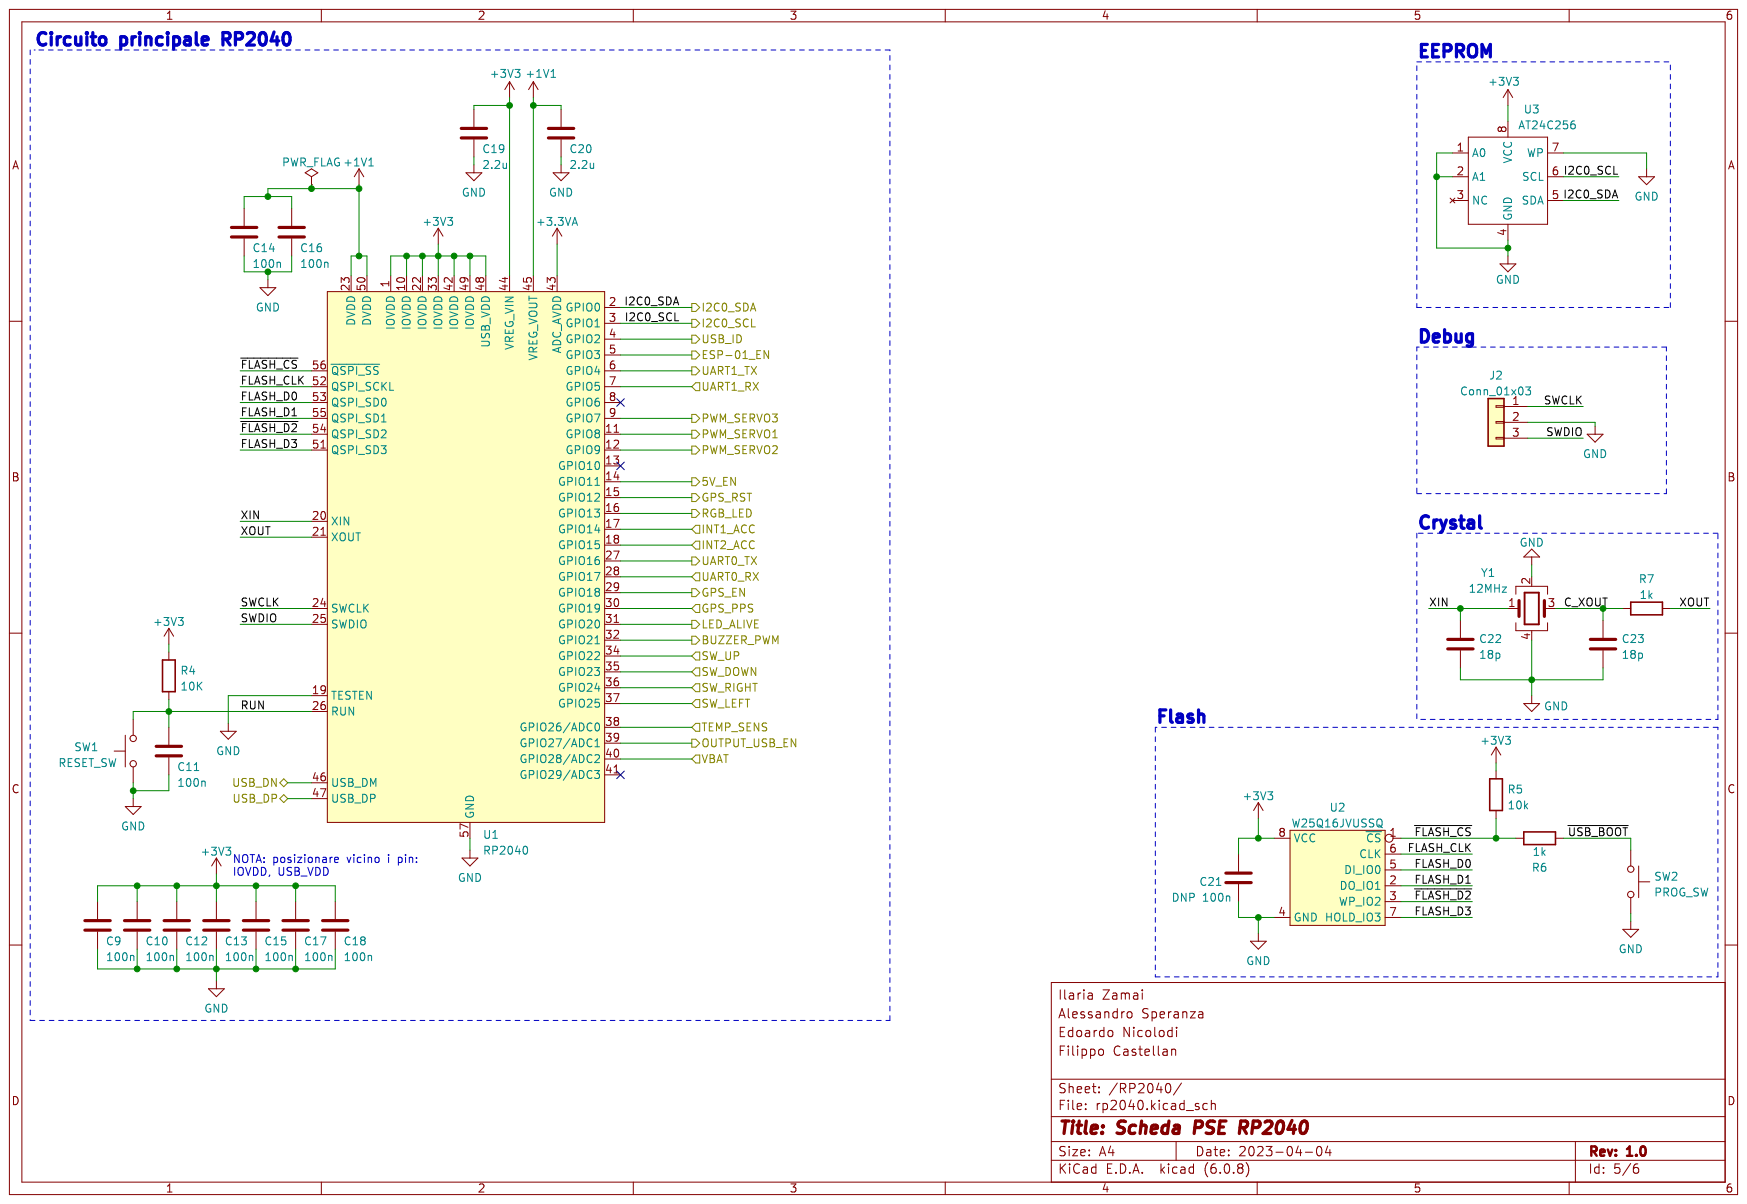
[picture p53: page 3]

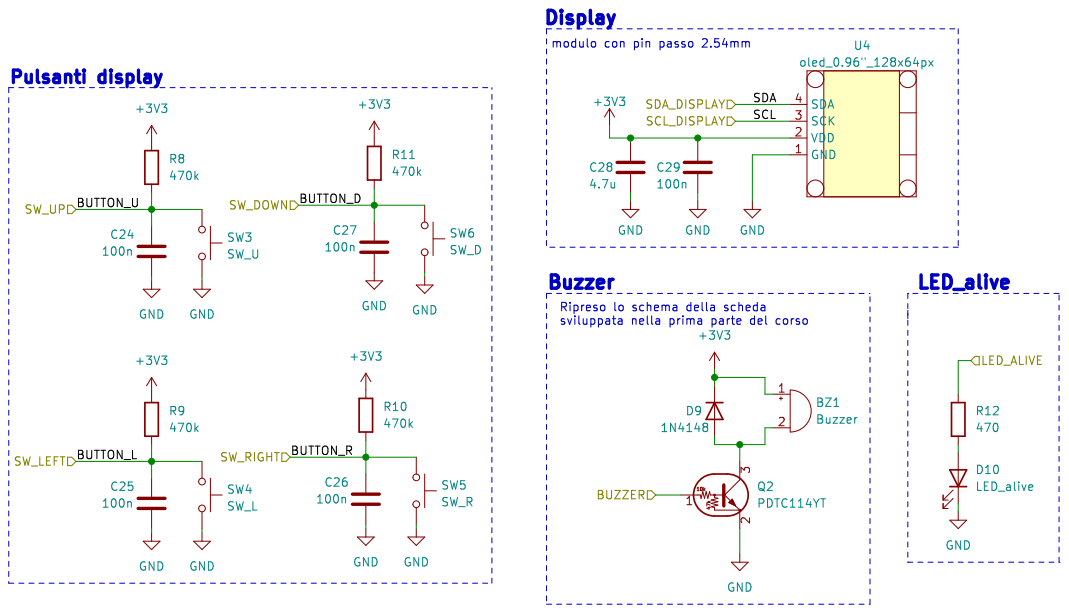
[picture p54: page 4]

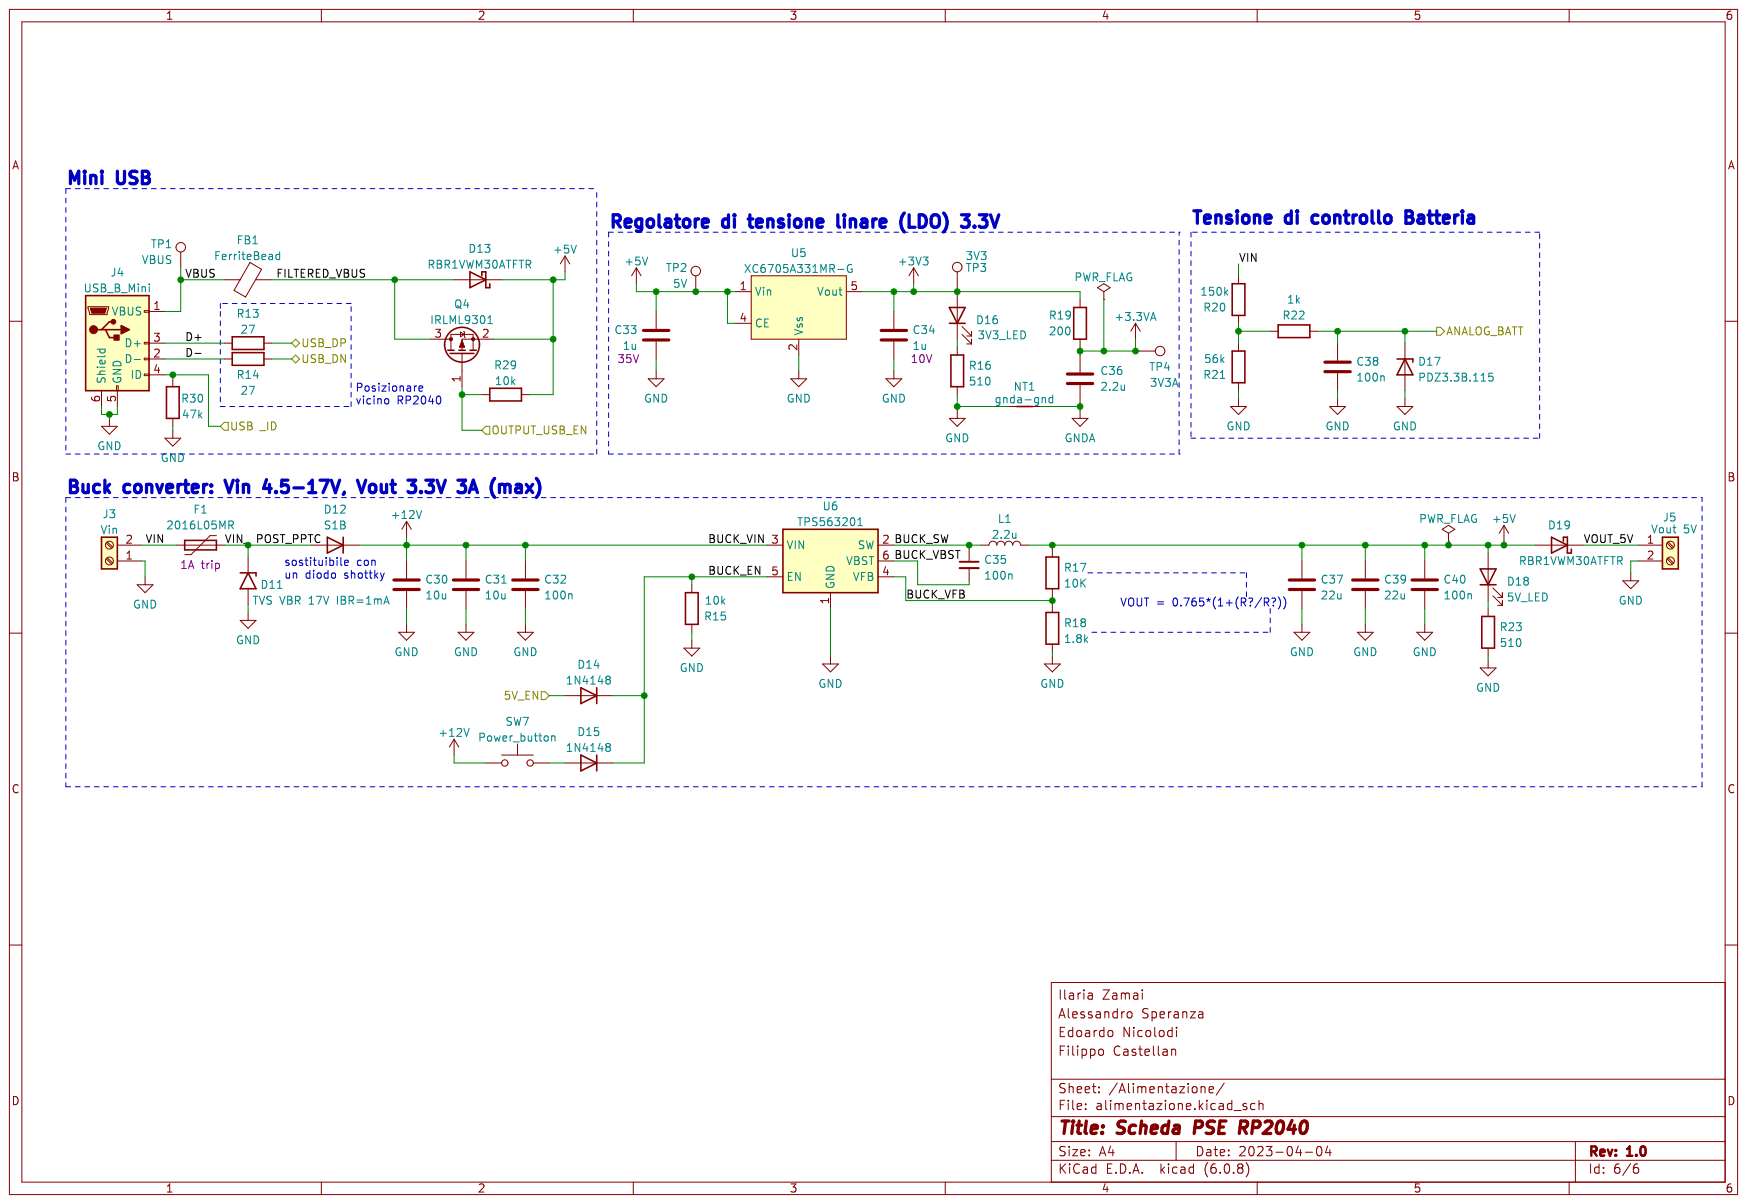
[picture p55: page 5]

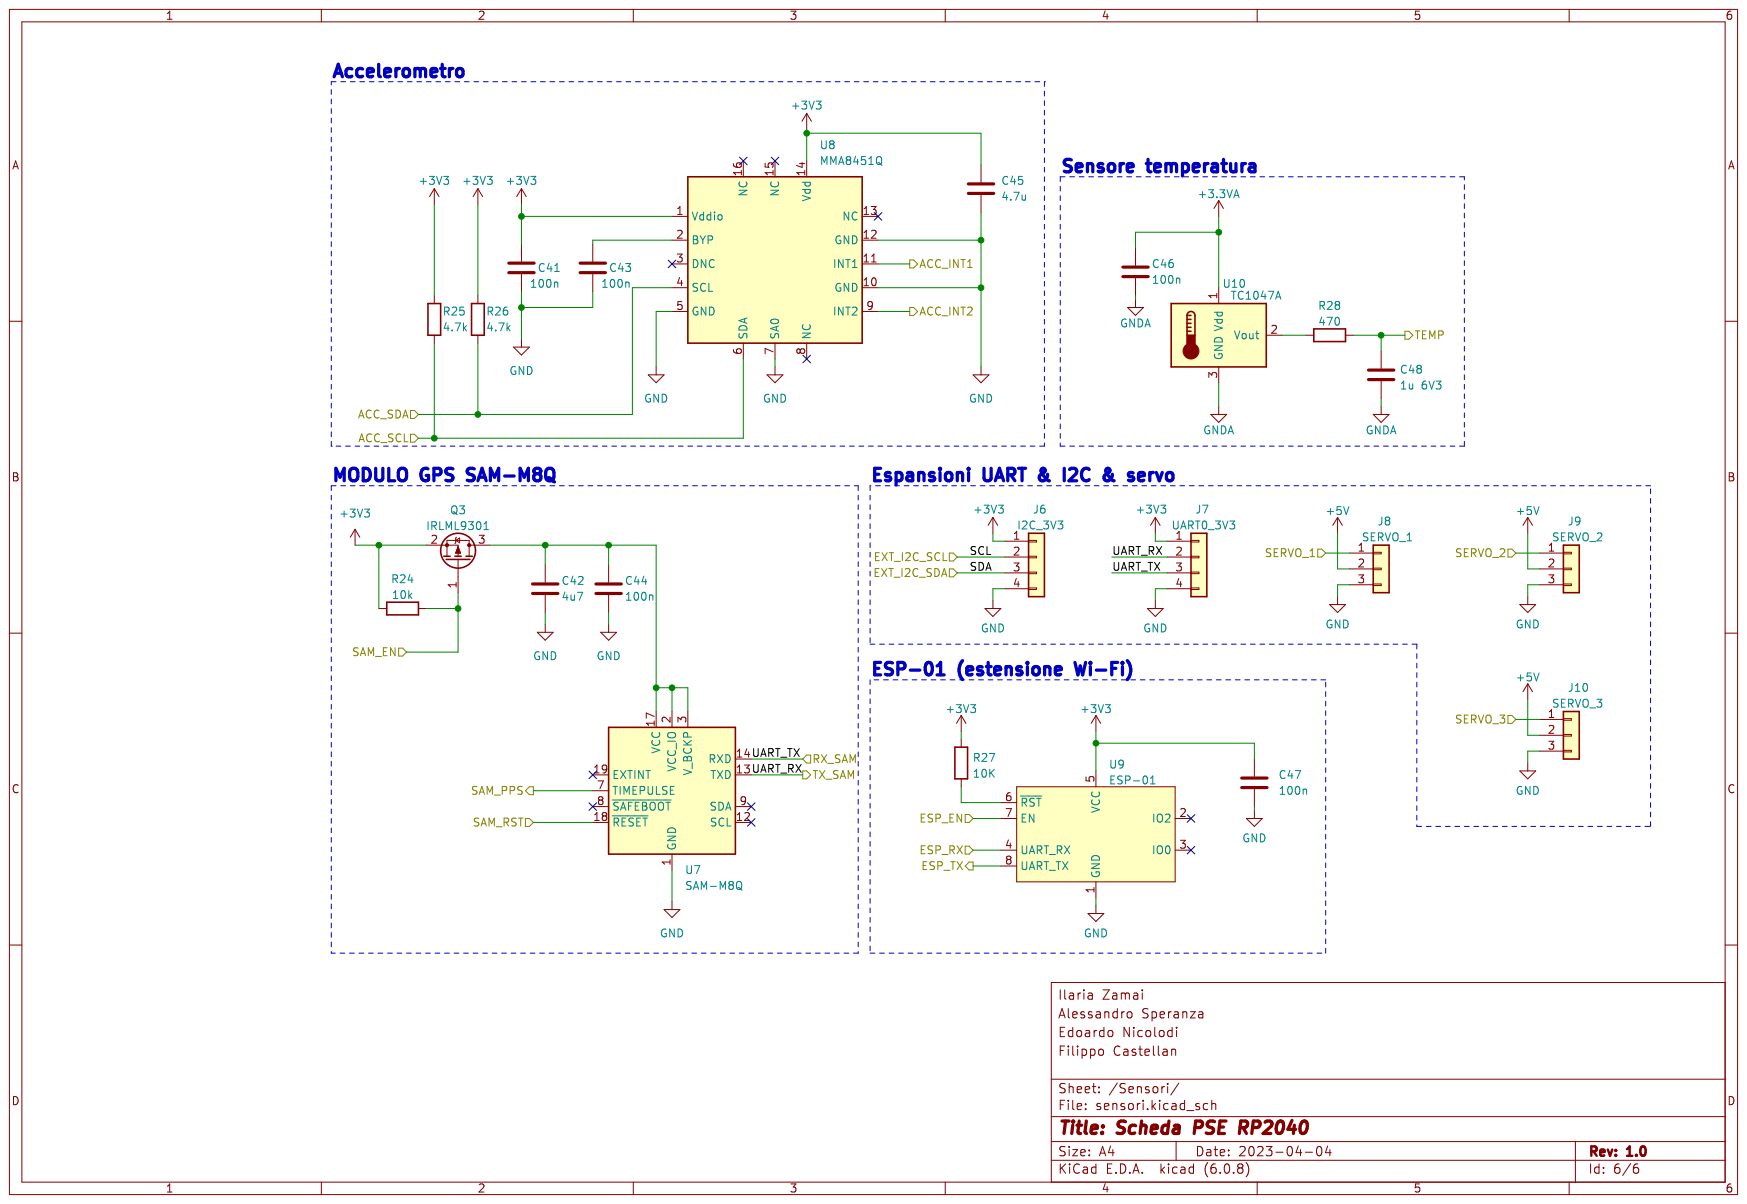
[picture p56: page 6]
