Eduzyolo/PSE_project/SCHEMATIC/scheda PSE/scheda PSE.kicad_pcb

## KiCad design SCHEMATIC/scheda PSE/scheda PSE.kicad_pcb (2023-04-20)

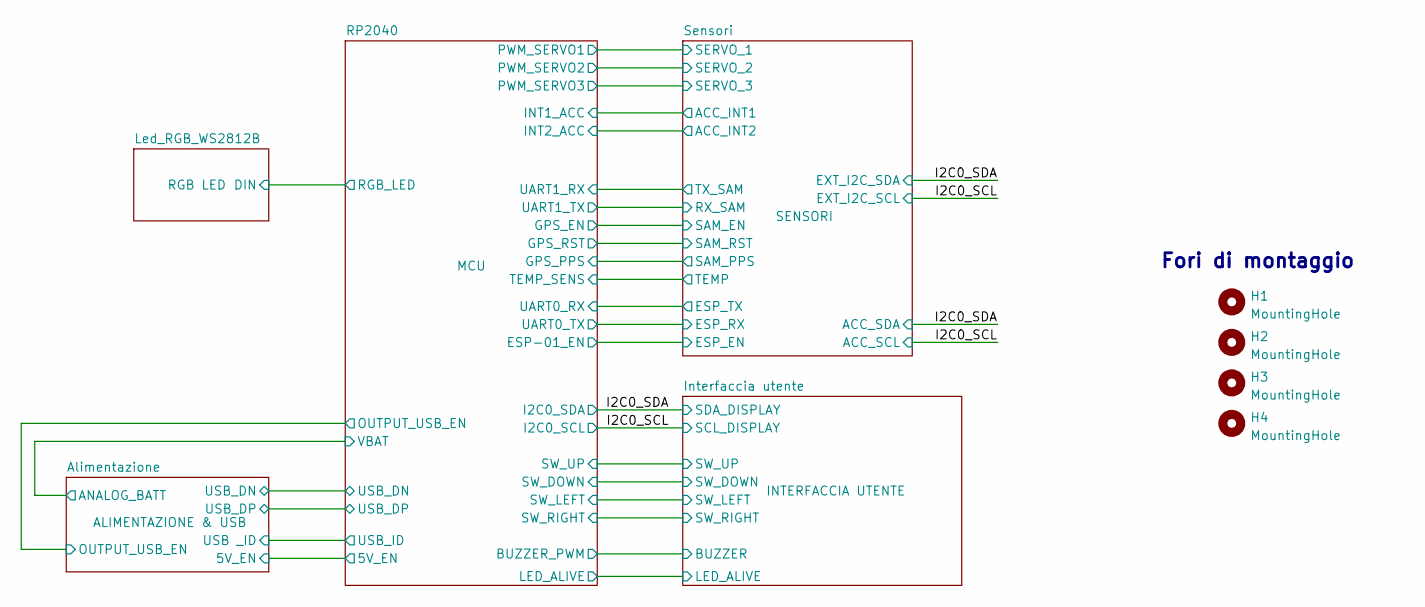
[picture p57: schematic scheda PSE.kicad_sch, Scheda PSE RP2040]

Parts:
H1, H2, H3, H4: MountingHole; MountingHole_3.2mm_M3_Pad_Via

Notes on the sheet:
Fori di montaggio

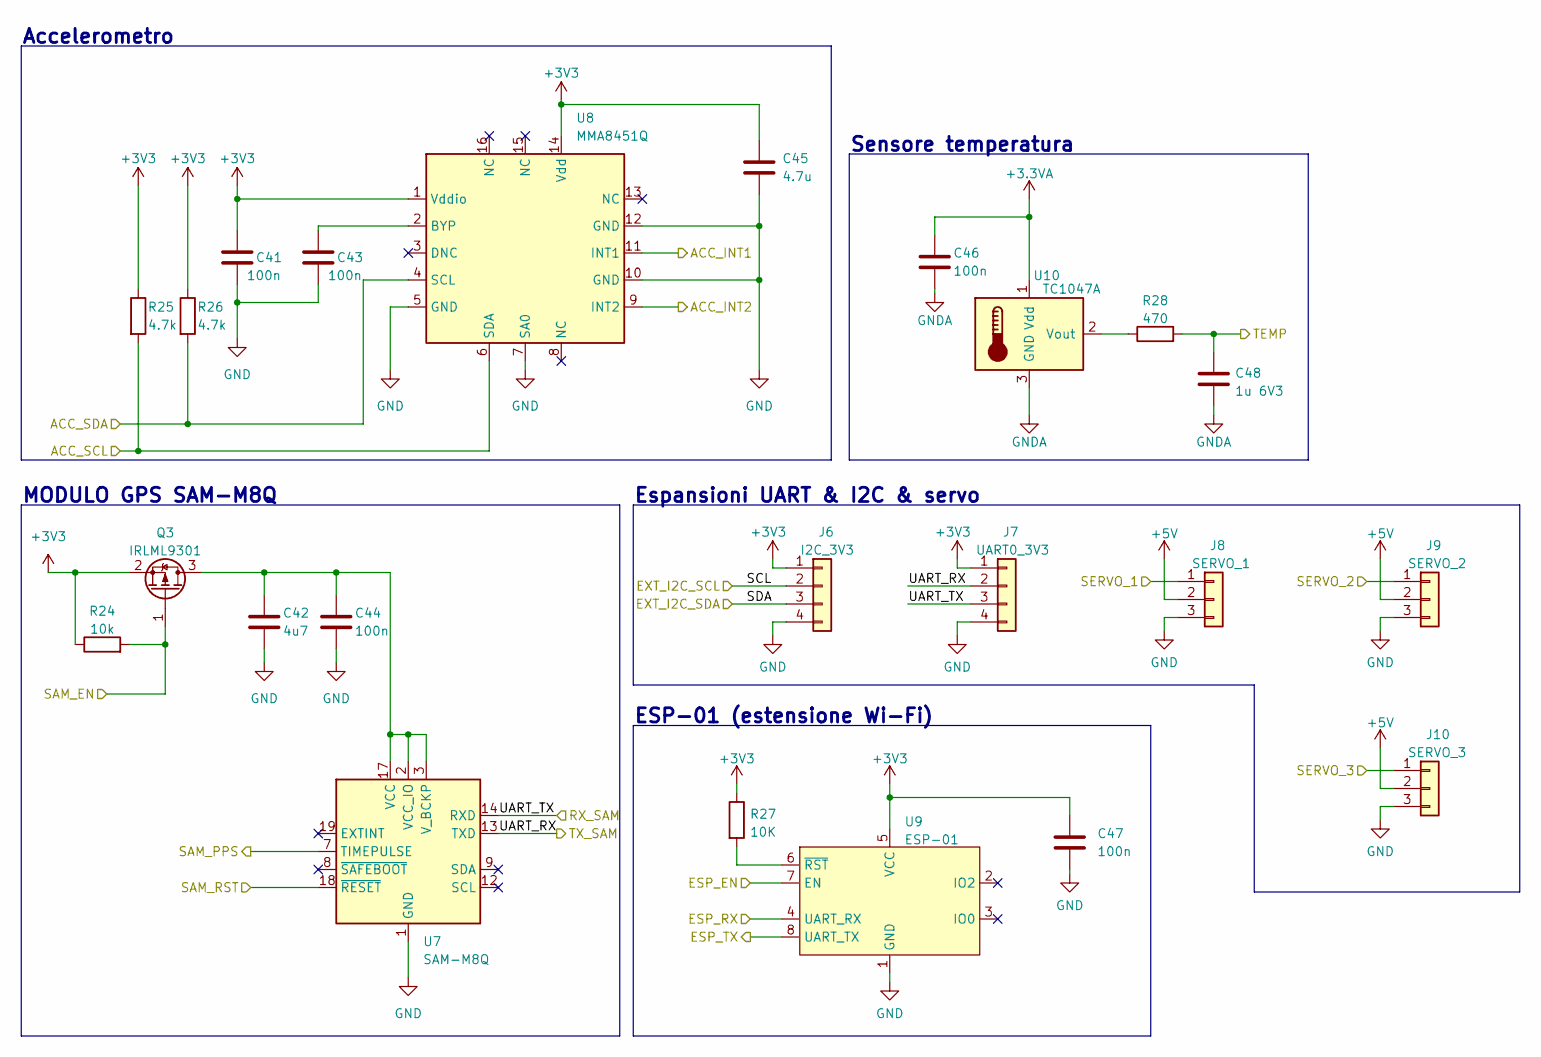
[picture p58: schematic sensori.kicad_sch, Scheda PSE RP2040]

Parts:
C41, C43, C44, C46, C47: 100n; C_0603_1608Metric
C42: 4u7; C_0603_1608Metric
C45: 4.7u; C_0603_1608Metric
C48: 1u 6V3; C_0603_1608Metric
J6: I2C_3V3; JST_XH_B4B-XH-A_1x04_P2.50mm_Vertical
J7: UART0_3V3; JST_XH_B4B-XH-A_1x04_P2.50mm_Vertical
J8: SERVO_1; PinHeader_1x03_P2.54mm_Vertical
J9: SERVO_2; PinHeader_1x03_P2.54mm_Vertical
J10: SERVO_3; PinHeader_1x03_P2.54mm_Vertical
Q3: IRLML9301; SOT-23
R24: 10k; R_0603_1608Metric
R25, R26: 4.7k; R_0603_1608Metric
R27: 10K; R_0603_1608Metric
R28: 470; R_0603_1608Metric
U7: SAM-M8Q; SAM_M8Q
U8: MMA8451Q; QFN-16
U9: ESP-01
U10: TC1047A; SOT-23

Connections:
+3.3VA: C46.1, U10.1 (Vdd); also elsewhere on the board
+3V3: C41.1, C45.1, C47.1, J6.1, J7.1, Q3.2 (S), R24.1, R25.1, R26.1, R27.1, U8.1 (Vddio), U8.14 (Vdd), U9.5 (VCC); also elsewhere on the board
+5V: J8.2, J9.2, J10.2; also elsewhere on the board
/I2C0_SCL: J6.2, R25.2, U8.6 (SDA); also elsewhere on the board
/I2C0_SDA: J6.3, R26.2, U8.4 (SCL); also elsewhere on the board
/RP2040/ESP-01_EN: U9.7 (EN); also elsewhere on the board
/RP2040/GPS_EN: Q3.1 (G), R24.2; also elsewhere on the board
/RP2040/GPS_PPS: U7.7 (TIMEPULSE); also elsewhere on the board
/RP2040/GPS_RST: U7.18 (~RESET); also elsewhere on the board
/RP2040/INT1_ACC: U8.11 (INT1); also elsewhere on the board
/RP2040/INT2_ACC: U8.9 (INT2); also elsewhere on the board
/RP2040/PWM_SERVO1: J8.1; also elsewhere on the board
/RP2040/PWM_SERVO2: J9.1; also elsewhere on the board
/RP2040/PWM_SERVO3: J10.1; also elsewhere on the board
/RP2040/TEMP_SENS: C48.1, R28.2; also elsewhere on the board
/RP2040/UART0_RX: U9.8 (UART_TX); also elsewhere on the board
/RP2040/UART0_TX: U9.4 (UART_RX); also elsewhere on the board
/Sensori/UART_RX: J7.2, U7.13 (TXD); also elsewhere on the board
/Sensori/UART_TX: J7.3, U7.14 (RXD); also elsewhere on the board
GND: C41.2, C42.2, C43.2, C44.2, C45.2, C47.2, J6.4, J7.4, J8.3, J9.3, J10.3, U7.1 (GND), U7.4 (GND), U7.5 (GND), U7.6 (GND), U7.10 (GND), U7.11 (GND), U7.15 (GND), U7.16 (GND), U7.20 (GND), U8.5 (GND), U8.7 (SA0), U8.10 (GND), U8.12 (GND), U9.1 (GND); also elsewhere on the board
GNDA: C46.2, C48.2, U10.3 (GND); also elsewhere on the board
unnamed: C42.1, C44.1, Q3.3 (D), U7.2 (VCC_IO), U7.3 (V_BCKP), U7.17 (VCC)
unnamed: C43.1, U8.2 (BYP)
unnamed: R27.2, U9.6 (~RST)
unnamed: R28.1, U10.2 (Vout)

Notes on the sheet:
MODULO GPS SAM-M8Q
Accelerometro
Espansioni UART & I2C & servo
ESP-01 (estensione Wi-Fi)
Sensore temperatura

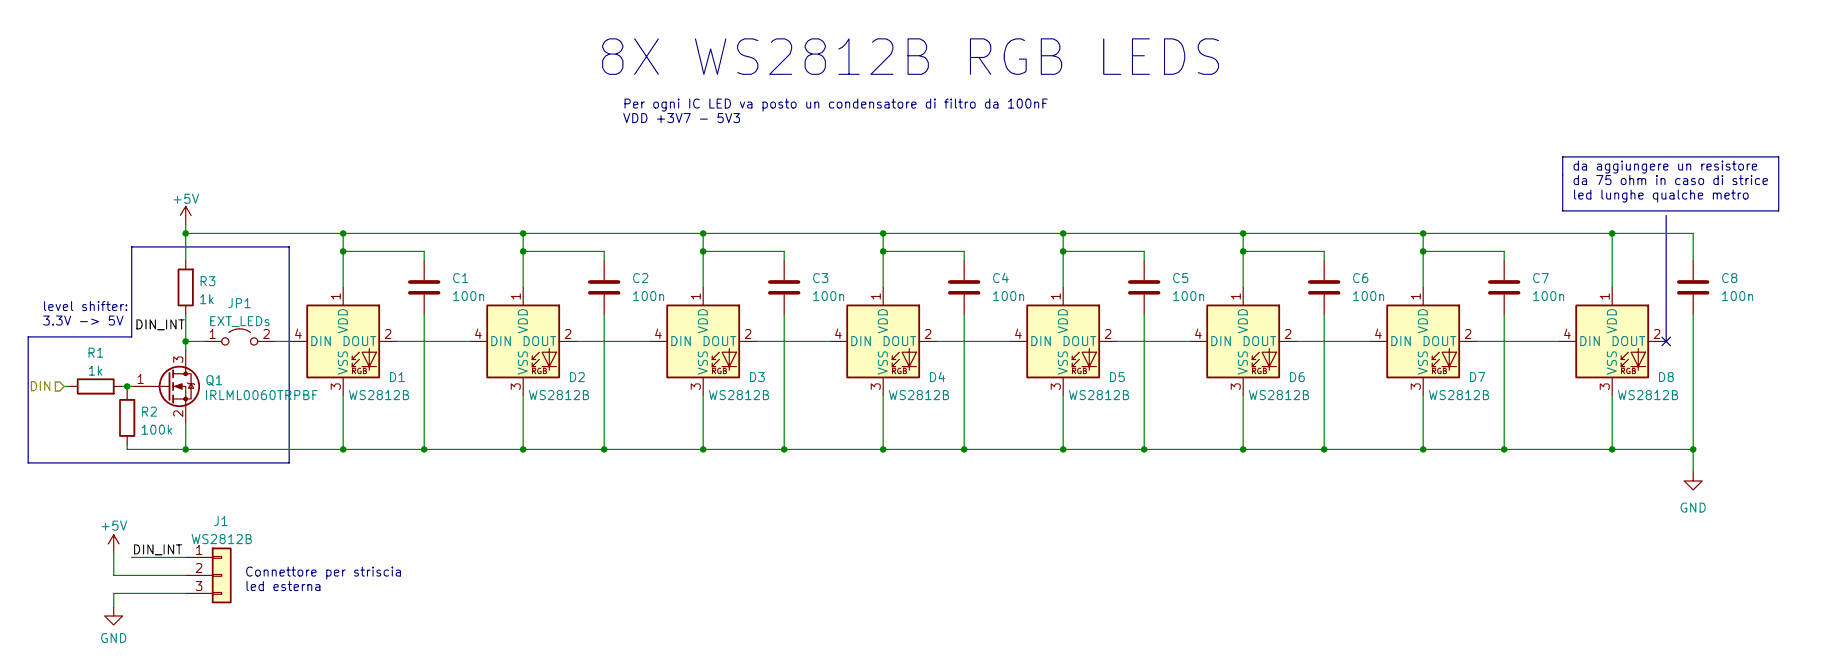
[picture p59: schematic Led_RGB_WS2812B.kicad_sch, Scheda PSE RP2040]

Parts:
C1, C2, C3, C4, C5, C6, C7, C8: 100n; C_0603_1608Metric
D1, D2, D3, D4, D5, D6, D7, D8: WS2812B; LED_WS2812B_PLCC4_5.0x5.0mm_P3.2mm
J1: WS2812B; JST_XH_B3B-XH-A_1x03_P2.50mm_Vertical
JP1: EXT_LEDs; PinHeader_1x02_P2.54mm_Vertical
Q1: IRLML0060TRPBF; SOT-23
R1, R3: 1k; R_0603_1608Metric
R2: 100k; R_0603_1608Metric

Connections:
+5V: C1.1, C2.1, C3.1, C4.1, C5.1, C6.1, C7.1, C8.1, D1.1 (VDD), D2.1 (VDD), D3.1 (VDD), D4.1 (VDD), D5.1 (VDD), D6.1 (VDD), D7.1 (VDD), D8.1 (VDD), J1.2, R3.2; also elsewhere on the board
/Led_RGB_WS2812B/DIN: R1.1; also elsewhere on the board
/Led_RGB_WS2812B/DIN_INT: J1.1, JP1.1 (A), Q1.3 (D), R3.1
GND: C1.2, C2.2, C3.2, C4.2, C5.2, C6.2, C7.2, C8.2, D1.3 (VSS), D2.3 (VSS), D3.3 (VSS), D4.3 (VSS), D5.3 (VSS), D6.3 (VSS), D7.3 (VSS), D8.3 (VSS), J1.3, Q1.2 (S), R2.1; also elsewhere on the board
unnamed: D1.2 (DOUT), D2.4 (DIN)
unnamed: D1.4 (DIN), JP1.2 (B)
unnamed: D2.2 (DOUT), D3.4 (DIN)
unnamed: D3.2 (DOUT), D4.4 (DIN)
unnamed: D4.2 (DOUT), D5.4 (DIN)
unnamed: D5.2 (DOUT), D6.4 (DIN)
unnamed: D6.2 (DOUT), D7.4 (DIN)
unnamed: D7.2 (DOUT), D8.4 (DIN)
unnamed: Q1.1 (G), R1.2, R2.2

Notes on the sheet:
Per ogni IC LED va posto un condensatore di filtro da 100nF VDD +3V7 - 5V3
Connettore per striscia led esterna
da aggiungere un resistore da 75 ohm in caso di strice led lunghe qualche metro
level shifter: 3.3V -> 5V
8X WS2812B RGB LEDS

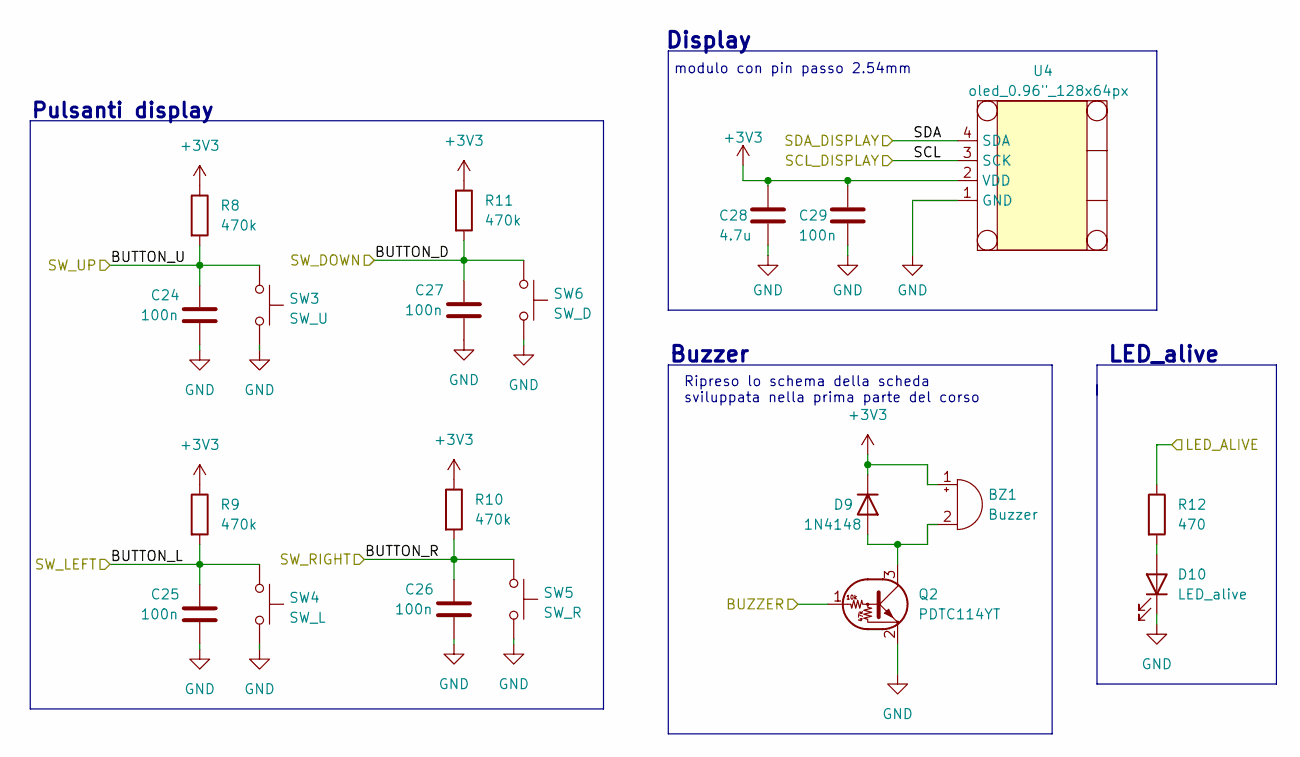
[picture p60: schematic Interfaccia_utente.kicad_sch, Scheda PSE RP2040]

Parts:
BZ1: Buzzer; MLT-8530
C24, C25, C26, C27, C29: 100n; C_0603_1608Metric
C28: 4.7u; C_0603_1608Metric
D9: 1N4148; D_SOD-123
D10: LED_alive; LED_0603_1608Metric
Q2: PDTC114YT; SOT-23
R8, R9, R10, R11: 470k; R_0603_1608Metric
R12: 470; R_0603_1608Metric
SW3: SW_U; SW_SPST_EVQP0
SW4: SW_L; SW_SPST_EVQP0
SW5: SW_R; SW_SPST_EVQP0
SW6: SW_D; SW_SPST_EVQP0
U4: oled_0.96"_128x64px; 128x64OLED

Connections:
+3V3: BZ1.1 (-), C28.1, C29.1, D9.1 (K), R8.1, R9.1, R10.1, R11.1, U4.2 (VDD); also elsewhere on the board
/I2C0_SCL: U4.3 (SCK); also elsewhere on the board
/I2C0_SDA: U4.4 (SDA); also elsewhere on the board
/Interfaccia utente/BUTTON_D: C27.1, R11.2, SW6.1; also elsewhere on the board
/Interfaccia utente/BUTTON_L: C25.1, R9.2, SW4.2; also elsewhere on the board
/Interfaccia utente/BUTTON_R: C26.1, R10.2, SW5.2; also elsewhere on the board
/Interfaccia utente/BUTTON_U: C24.1, R8.2, SW3.2; also elsewhere on the board
/Interfaccia utente/BUZZER: Q2.1 (B); also elsewhere on the board
/Interfaccia utente/LED_ALIVE: R12.1; also elsewhere on the board
GND: C24.2, C25.2, C26.2, C27.2, C28.2, C29.2, D10.1 (K), Q2.2 (E), SW3.1, SW4.1, SW5.1, SW6.2, U4.1 (GND); also elsewhere on the board
unnamed: BZ1.2 (+), D9.2 (A), Q2.3 (C)
unnamed: D10.2 (A), R12.2

Notes on the sheet:
Display
modulo con pin passo 2.54mm
Buzzer
LED_alive
Pulsanti display
Ripreso lo schema della scheda sviluppata nella prima parte del corso

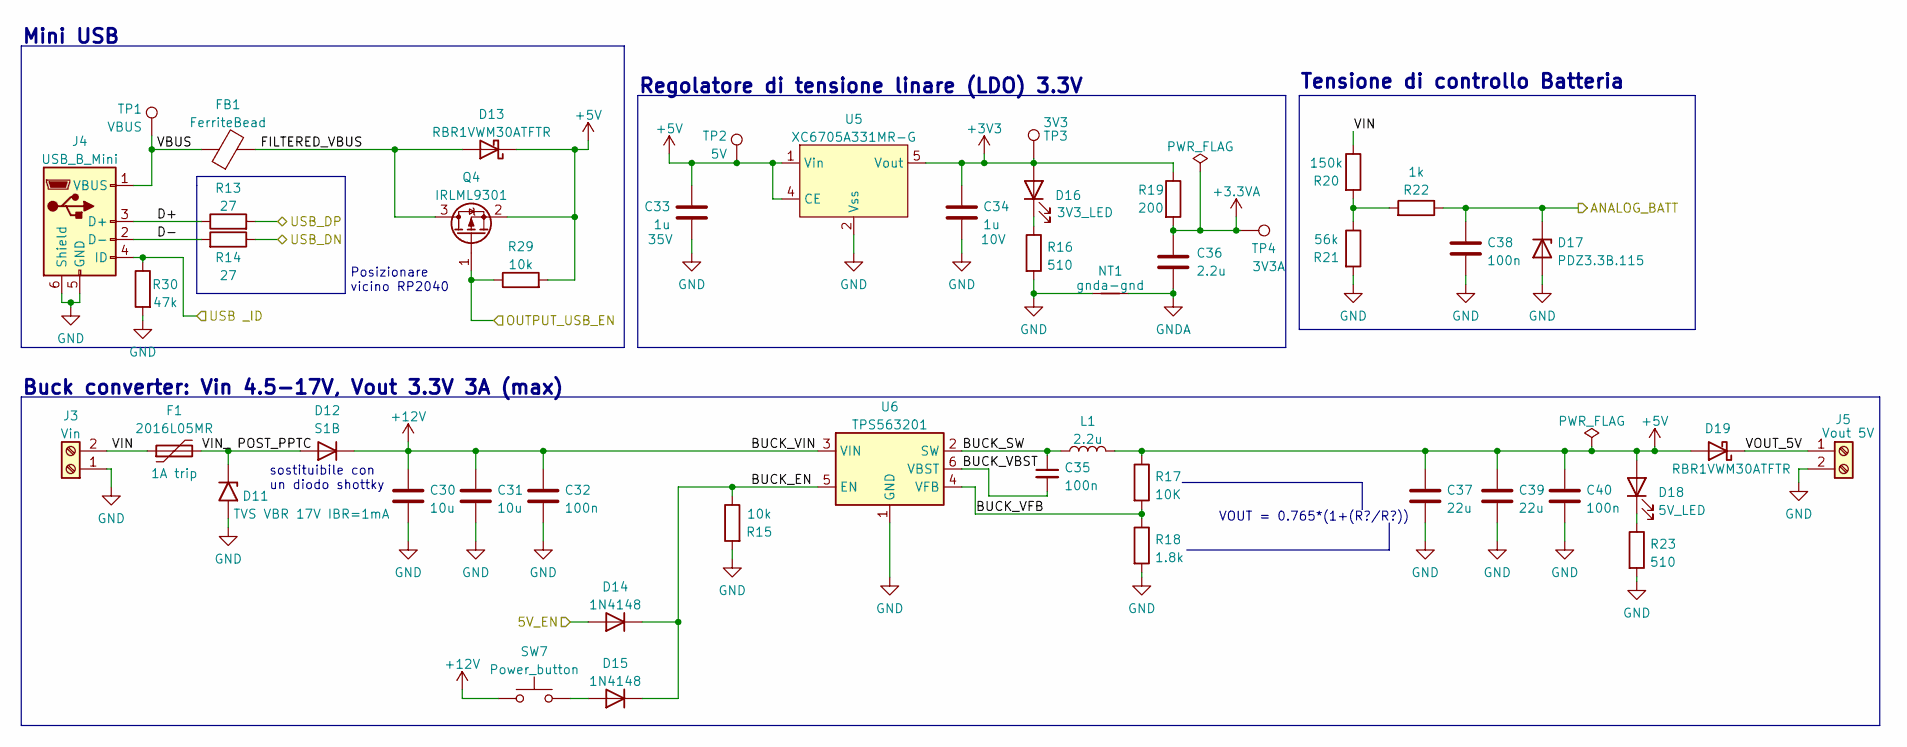
[picture p61: schematic alimentazione.kicad_sch, Scheda PSE RP2040]

Parts:
C30, C31: 10u; C_0805_2012Metric
C32, C35, C38, C40: 100n; C_0603_1608Metric
C33: 1u; C_0603_1608Metric; Voltage 35V
C34: 1u; C_0603_1608Metric; Voltage 10V
C36: 2.2u; C_0603_1608Metric
C37, C39: 22u; C_0805_2012Metric
D11: TVS VBR 17V IBR=1mA; D_SMA; mouser 576-SMAJ15A
D12: S1B; D_SMA; farnell 2675037
D13, D19: RBR1VWM30ATFTR; D_SOD-123; farnell 2311223
D14, D15: 1N4148; D_SOD-123
D16: 3V3_LED; LED_0805_2012Metric
D17: PDZ3.3B.115; D_SOD-323_HandSoldering
D18: 5V_LED; LED_0805_2012Metric
F1: 2016L05MR; Fuse_1206_3216Metric; Rating 1A trip; farnell 1652159
FB1: FerriteBead; C_0805_2012Metric; farnell 1515661
J3: Vin; TerminalBlock_bornier-2_P5.08mm
J4: USB_B_Mini; USB mini
J5: Vout 5V; TerminalBlock_bornier-2_P5.08mm
L1: 2.2u; IHLP1212BZER2R2M11; farnell 2056527
NT1: gnda-gnd; NetTie-2_SMD_Pad0.5mm
Q4: IRLML9301; SOT-23
R13, R14: 27; R_0603_1608Metric
R15, R29: 10k; R_0603_1608Metric
R16, R23: 510; R_0603_1608Metric
R17: 10K; R_0603_1608Metric
R18: 1.8k; R_0603_1608Metric
R19: 200; R_0603_1608Metric
R20: 150k; R_0603_1608Metric
R21: 56k; R_0603_1608Metric
R22: 1k; R_0603_1608Metric
R30: 47k; R_0603_1608Metric
SW7: Power_button; SW_SPST_EVQP0
TP1: VBUS; TestPoint_THTPad_D1.5mm_Drill0.7mm
TP2: 5V; TestPoint_THTPad_D1.5mm_Drill0.7mm
TP3: 3V3; TestPoint_THTPad_D1.5mm_Drill0.7mm
TP4: 3V3A; TestPoint_THTPad_D1.5mm_Drill0.7mm
U5: XC6705A331MR-G; SOT-23-5; farnell 4144775
U6: TPS563201; SOT-23-6

Connections:
+3.3VA: C36.1, R19.2, TP4.1; also elsewhere on the board
+3V3: C34.1, D16.2 (A), R19.1, TP3.1, U5.5 (Vout); also elsewhere on the board
+5V: C33.1, C37.1, C39.1, C40.1, D13.1 (K), D18.2 (A), D19.2 (A), L1.2, Q4.2 (S), R17.1, R29.2, TP2.1, U5.1 (Vin), U5.4 (CE); also elsewhere on the board
+12V: C30.1, C31.1, C32.1, D12.1 (K), SW7.1, U6.3 (VIN)
/Alimentazione/5V_EN: D14.2 (A); also elsewhere on the board
/Alimentazione/ANALOG_BATT: C38.1, D17.1 (K), R22.1; also elsewhere on the board
/Alimentazione/BUCK_EN: D14.1 (K), D15.1 (K), R15.1, U6.5 (EN)
/Alimentazione/BUCK_SW: C35.1, L1.1, U6.2 (SW)
/Alimentazione/BUCK_VBST: C35.2, U6.6 (VBST)
/Alimentazione/BUCK_VFB: R17.2, R18.1, U6.4 (VFB)
/Alimentazione/D+: J4.3 (D+), R13.1
/Alimentazione/D-: J4.2 (D-), R14.2
/Alimentazione/FILTERED_VBUS: D13.2 (A), FB1.2, Q4.3 (D)
/Alimentazione/OUTPUT_USB_EN: Q4.1 (G), R29.1; also elsewhere on the board
/Alimentazione/USB _ID: J4.4 (ID), R30.1; also elsewhere on the board
/Alimentazione/USB_DN: R14.1; also elsewhere on the board
/Alimentazione/USB_DP: R13.2; also elsewhere on the board
/Alimentazione/VBUS: FB1.1, J4.1 (VBUS), TP1.1
/Alimentazione/VIN: F1.1, J3.2, R20.1
/Alimentazione/VIN_ POST_PPTC: D11.1 (A1), D12.2 (A), F1.2
/Alimentazione/VOUT_5V: D19.1 (K), J5.1
GND: C30.2, C31.2, C32.2, C33.2, C34.2, C37.2, C38.2, C39.2, C40.2, D11.2 (A2), D17.2 (A), J3.1, J4.5 (GND), J4.6 (Shield), J5.2, NT1.1, R15.2, R16.2, R18.2, R21.2, R23.2, R30.2, U5.2 (Vss), U6.1 (GND); also elsewhere on the board
GNDA: C36.2, NT1.2; also elsewhere on the board
unnamed: D15.2 (A), SW7.2
unnamed: D16.1 (K), R16.1
unnamed: D18.1 (K), R23.1
unnamed: R20.2, R21.1, R22.2

Notes on the sheet:
Tensione di controllo Batteria
Posizionare vicino RP2040
sostituibile con un diodo shottky
Buck converter: Vin 4.5-17V, Vout 3.3V 3A (max)
VOUT = 0.765*(1+(R?/R?))
Regolatore di tensione linare (LDO) 3.3V
Mini USB

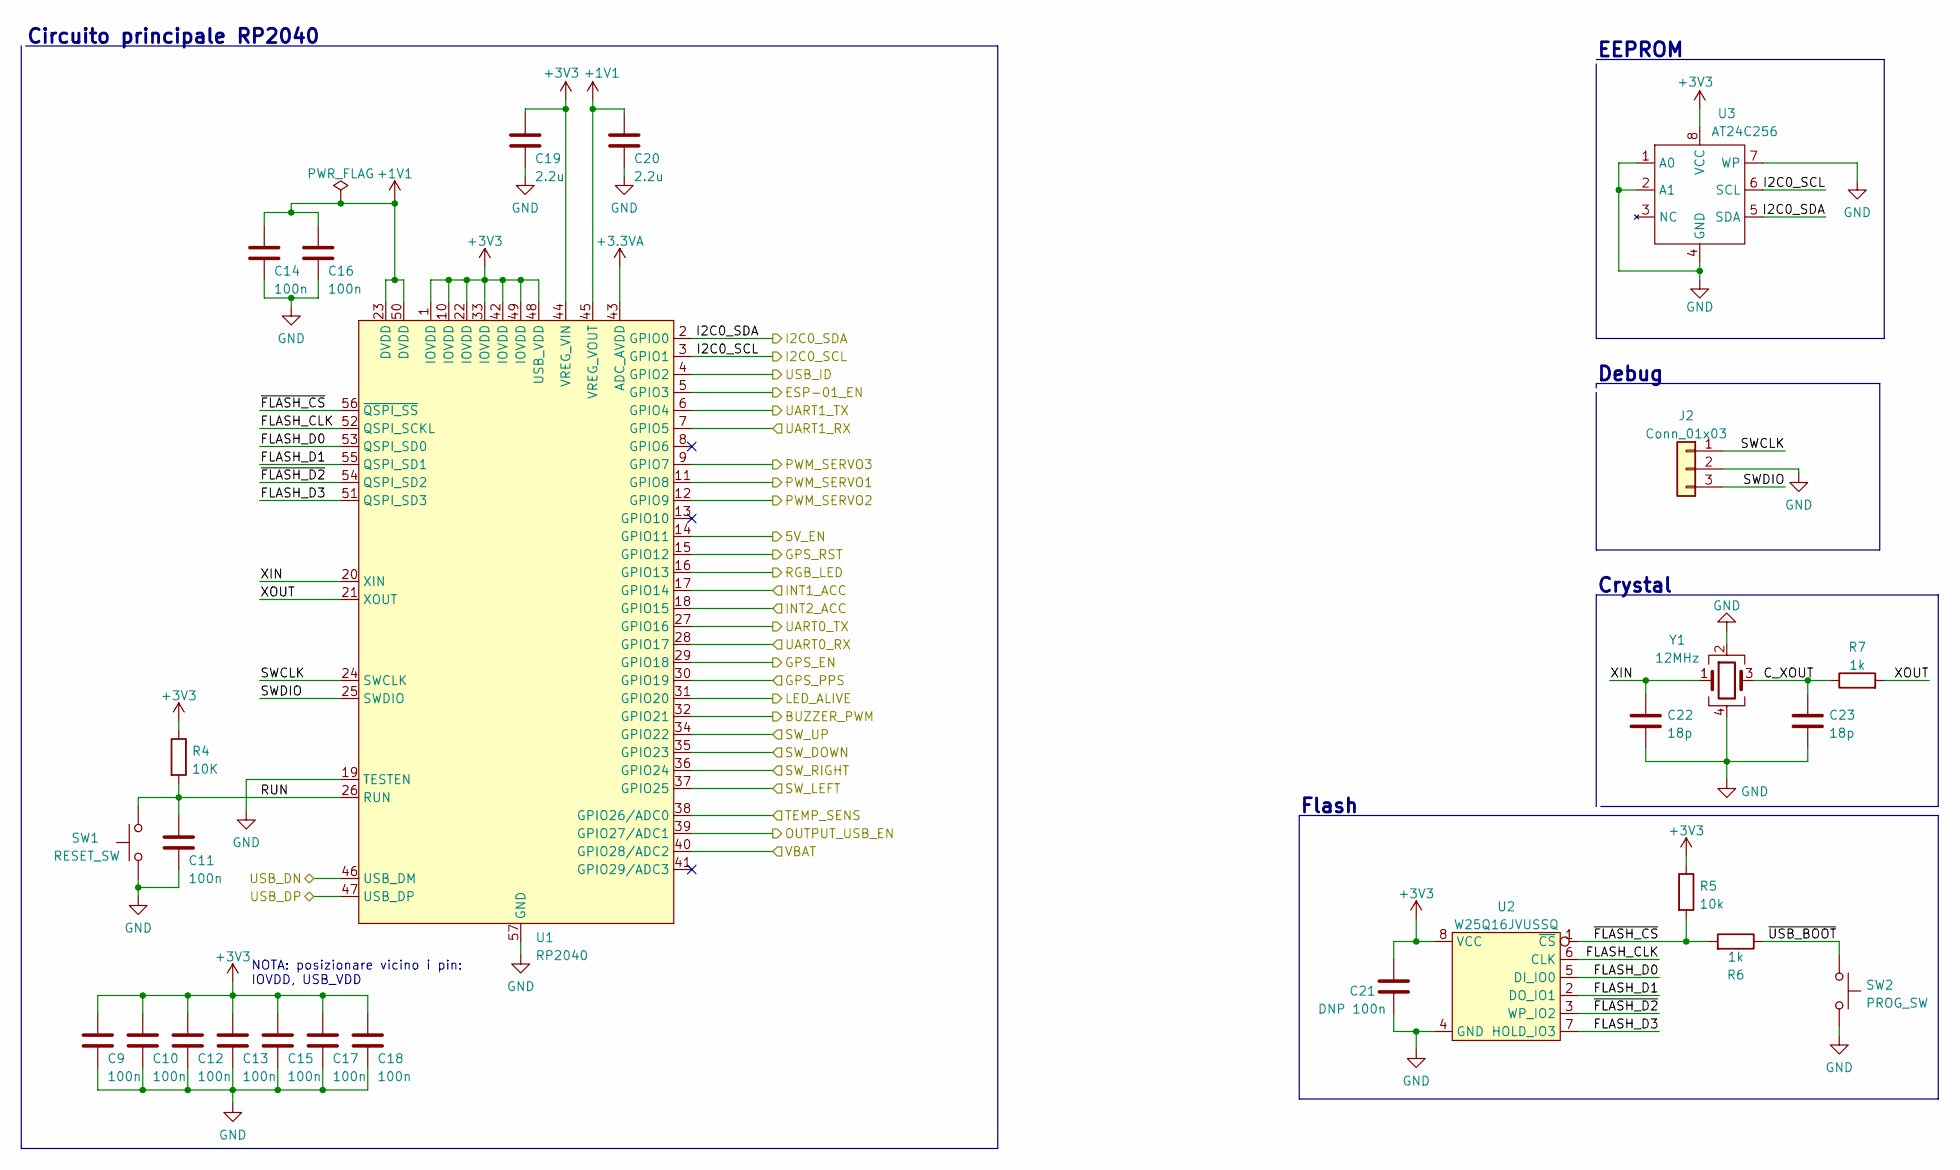
[picture p62: schematic rp2040.kicad_sch, Scheda PSE RP2040]

Parts:
C9, C10, C11, C12, C13, C14, C15, C16, C17, C18: 100n; C_0603_1608Metric
C19, C20: 2.2u; C_0603_1608Metric
C21: DNP 100n; C_0603_1608Metric
C22, C23: 18p; C_0603_1608Metric
J2: Conn_01x03; PinHeader_1x03_P2.54mm_Vertical
R4: 10K; R_0603_1608Metric
R5: 10k; R_0603_1608Metric
R6, R7: 1k; R_0603_1608Metric
SW1: RESET_SW; SW_SPST_EVQP0
SW2: PROG_SW; SW_SPST_EVQP0
U1: RP2040; QFN40P700X700X90-57N-D
U2: W25Q16JVUSSQ; SOIC8-150mils
U3: AT24C256; SOIC-8_3.9x4.9mm_P1.27mm
Y1: 12MHz; Crystal_SMD_3225-4Pin_3.2x2.5mm_HandSoldering

Connections:
+1V1: C14.1, C16.1, C20.1, U1.23 (DVDD), U1.45 (VREG_VOUT), U1.50 (DVDD)
+3.3VA: U1.43 (ADC_AVDD); also elsewhere on the board
+3V3: C9.1, C10.1, C12.1, C13.1, C15.1, C17.1, C18.1, C19.1, C21.1, R4.1, R5.1, U1.1 (IOVDD), U1.10 (IOVDD), U1.22 (IOVDD), U1.33 (IOVDD), U1.42 (IOVDD), U1.44 (VREG_VIN), U1.48 (USB_VDD), U1.49 (IOVDD), U2.8 (VCC), U3.8 (VCC); also elsewhere on the board
/Alimentazione/5V_EN: U1.14 (GPIO11); also elsewhere on the board
/Alimentazione/ANALOG_BATT: U1.40 (GPIO28/ADC2); also elsewhere on the board
/Alimentazione/OUTPUT_USB_EN: U1.39 (GPIO27/ADC1); also elsewhere on the board
/Alimentazione/USB _ID: U1.4 (GPIO2); also elsewhere on the board
/Alimentazione/USB_DN: U1.46 (USB_DM); also elsewhere on the board
/Alimentazione/USB_DP: U1.47 (USB_DP); also elsewhere on the board
/I2C0_SCL: U1.3 (GPIO1), U3.6 (SCL); also elsewhere on the board
/I2C0_SDA: U1.2 (GPIO0), U3.5 (SDA); also elsewhere on the board
/Interfaccia utente/BUTTON_D: U1.35 (GPIO23); also elsewhere on the board
/Interfaccia utente/BUTTON_L: U1.37 (GPIO25); also elsewhere on the board
/Interfaccia utente/BUTTON_R: U1.36 (GPIO24); also elsewhere on the board
/Interfaccia utente/BUTTON_U: U1.34 (GPIO22); also elsewhere on the board
/Interfaccia utente/BUZZER: U1.32 (GPIO21); also elsewhere on the board
/Interfaccia utente/LED_ALIVE: U1.31 (GPIO20); also elsewhere on the board
/Led_RGB_WS2812B/DIN: U1.16 (GPIO13); also elsewhere on the board
/RP2040/C_XOUT: C23.1, R7.1, Y1.3
/RP2040/ESP-01_EN: U1.5 (GPIO3); also elsewhere on the board
/RP2040/FLASH_CLK: U1.52 (QSPI_SCKL), U2.6 (CLK)
/RP2040/FLASH_D0: U1.53 (QSPI_SD0), U2.5 (DI_IO0)
/RP2040/FLASH_D1: U1.55 (QSPI_SD1), U2.2 (DO_IO1)
/RP2040/FLASH_D3: U1.51 (QSPI_SD3), U2.7 (HOLD_IO3)
/RP2040/GPS_EN: U1.29 (GPIO18); also elsewhere on the board
/RP2040/GPS_PPS: U1.30 (GPIO19); also elsewhere on the board
/RP2040/GPS_RST: U1.15 (GPIO12); also elsewhere on the board
/RP2040/INT1_ACC: U1.17 (GPIO14); also elsewhere on the board
/RP2040/INT2_ACC: U1.18 (GPIO15); also elsewhere on the board
/RP2040/PWM_SERVO1: U1.11 (GPIO8); also elsewhere on the board
/RP2040/PWM_SERVO2: U1.12 (GPIO9); also elsewhere on the board
/RP2040/PWM_SERVO3: U1.9 (GPIO7); also elsewhere on the board
/RP2040/RUN: C11.1, R4.2, SW1.2, U1.26 (RUN)
/RP2040/SWCLK: J2.1, U1.24 (SWCLK)
/RP2040/SWDIO: J2.3, U1.25 (SWDIO)
/RP2040/TEMP_SENS: U1.38 (GPIO26/ADC0); also elsewhere on the board
/RP2040/UART0_RX: U1.28 (GPIO17); also elsewhere on the board
/RP2040/UART0_TX: U1.27 (GPIO16); also elsewhere on the board
/RP2040/XIN: C22.1, U1.20 (XIN), Y1.1
/RP2040/XOUT: R7.2, U1.21 (XOUT)
/RP2040/~FLASH_CS: R5.2, R6.2, U1.56 (~QSPI_SS), U2.1 (~CS)
/RP2040/~FLASH_D2: U1.54 (QSPI_SD2), U2.3 (WP_IO2)
/RP2040/~USB_BOOT: R6.1, SW2.1
/Sensori/UART_RX: U1.7 (GPIO5); also elsewhere on the board
/Sensori/UART_TX: U1.6 (GPIO4); also elsewhere on the board
GND: C9.2, C10.2, C11.2, C12.2, C13.2, C14.2, C15.2, C16.2, C17.2, C18.2, C19.2, C20.2, C21.2, C22.2, C23.2, J2.2, SW1.1, SW2.2, U1.19 (TESTEN), U1.57 (GND), U2.4 (GND), U3.1 (A0), U3.2 (A1), U3.4 (GND), U3.7 (WP), Y1.2, Y1.4; also elsewhere on the board

Notes on the sheet:
EEPROM
Crystal
Circuito principale RP2040
NOTA: posizionare vicino i pin: IOVDD, USB_VDD
Flash
Debug

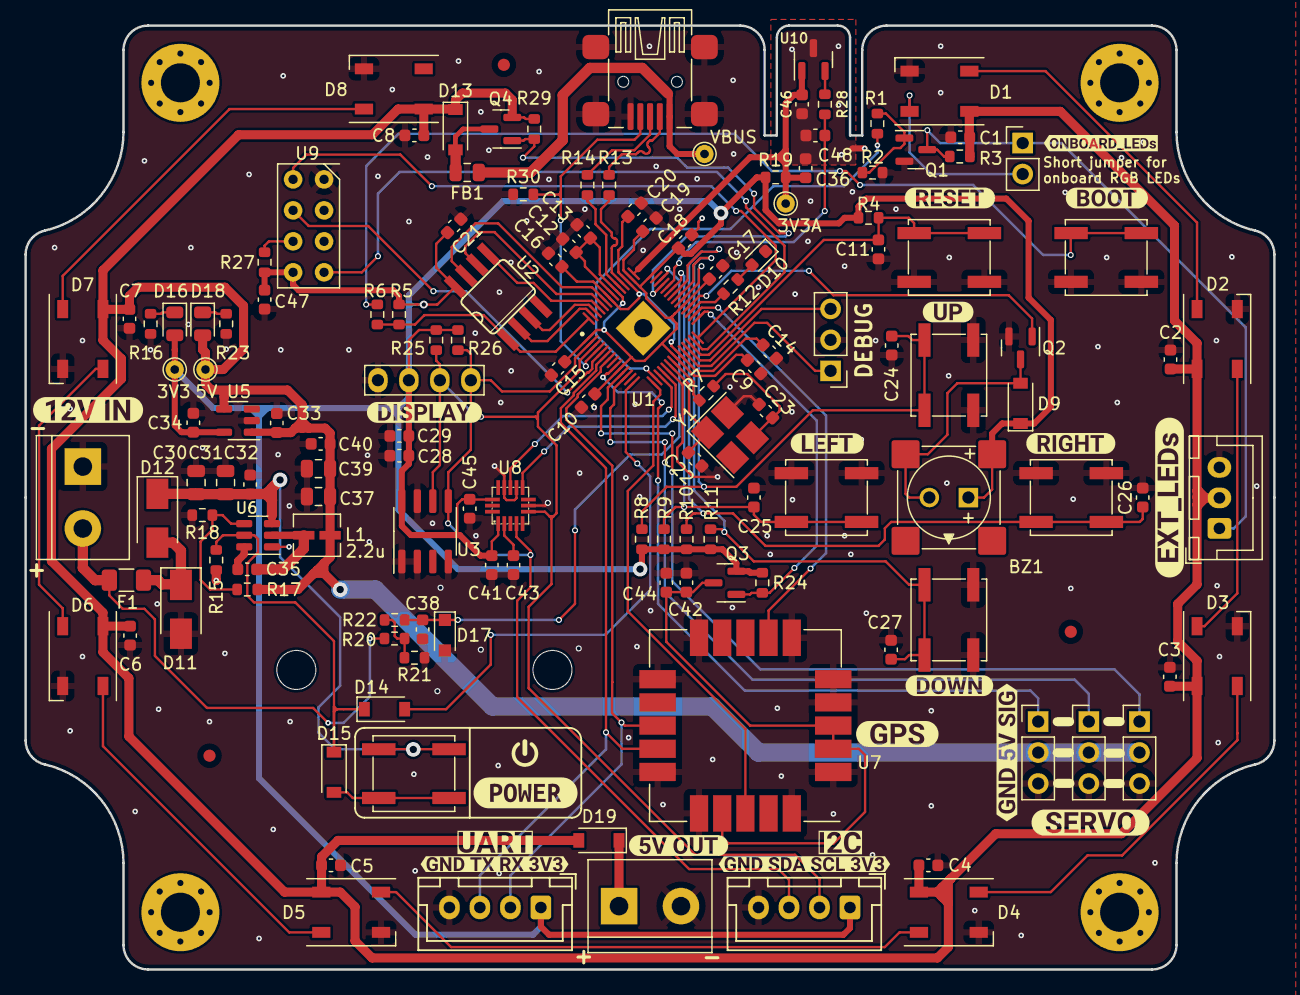
[picture p63: board scheda PSE.kicad_pcb from above]

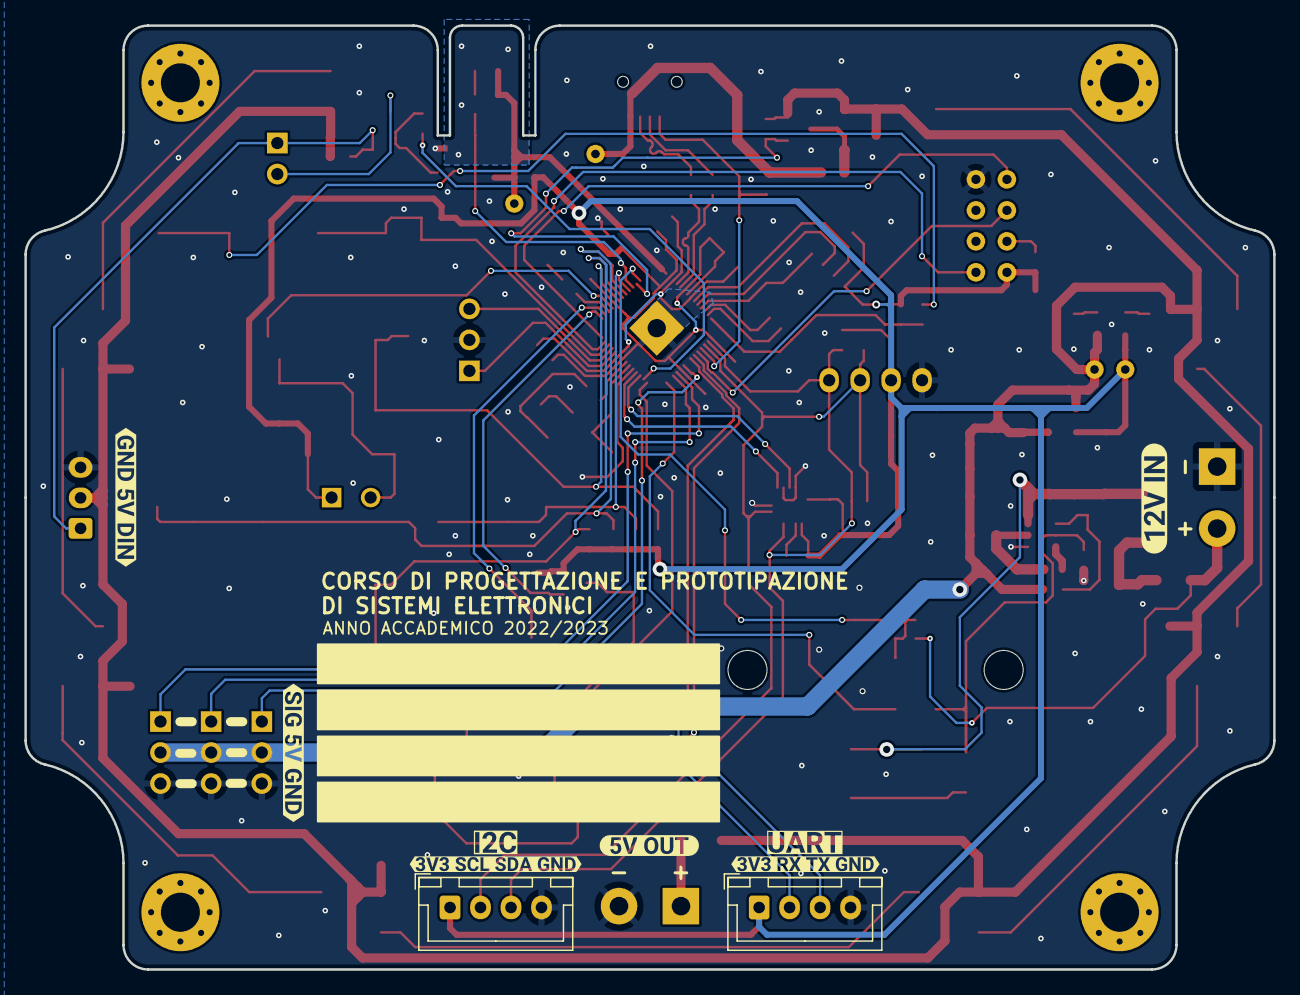
[picture p64: board scheda PSE.kicad_pcb from below]

Board: 2 copper layers, 102.4 x 77.4 mm, 170 parts (10 on the bottom side), 80 nets.

Other parts of the board:
kibuzzard-643CF7B7, kibuzzard-643CF7B7#2: G***; kibuzzard-643CF7B7
kibuzzard-643CF7E4: G***; kibuzzard-643CF7E4
kibuzzard-643CF8F2: G***; kibuzzard-643CF8F2
kibuzzard-643CF9A0: G***; kibuzzard-643CF9A0
kibuzzard-643CF9B2: G***; kibuzzard-643CF9B2
kibuzzard-643CF9C9: G***; kibuzzard-643CF9C9
kibuzzard-643CF80B, kibuzzard-643CF80B#2: G***; kibuzzard-643CF80B
kibuzzard-643CF88B: G***; kibuzzard-643CF88B
kibuzzard-643CF96E: G***; kibuzzard-643CF96E
kibuzzard-643CF430: G***; kibuzzard-643CF430
kibuzzard-643CF710: G***; kibuzzard-643CF710
kibuzzard-643CF960: G***; kibuzzard-643CF960
kibuzzard-643CF993: G***; kibuzzard-643CF993
kibuzzard-643CFA52, kibuzzard-643CFA52#2: G***; kibuzzard-643CFA52
kibuzzard-643CFABC, kibuzzard-643CFABC#2: G***; kibuzzard-643CFABC
kibuzzard-643CFBDA: G***; kibuzzard-643CFBDA
kibuzzard-643D3A9E: G***; kibuzzard-643D3A9E
kibuzzard-643DAACA: G***; kibuzzard-643DAACA
kibuzzard-643E45C8: G***; kibuzzard-643E45C8
kibuzzard-643E45D3: G***; kibuzzard-643E45D3
kibuzzard-643E4714: G***; kibuzzard-643E4714
kibuzzard-643E4784: G***; kibuzzard-643E4784
kibuzzard-644128D0: G***; kibuzzard-644128D0
