Eduzyolo/PSE_project/SCHEMATIC/ENCODER/ENCODER.kicad_pcb

## KiCad design SCHEMATIC/ENCODER/ENCODER.kicad_pcb (2023-04-13)

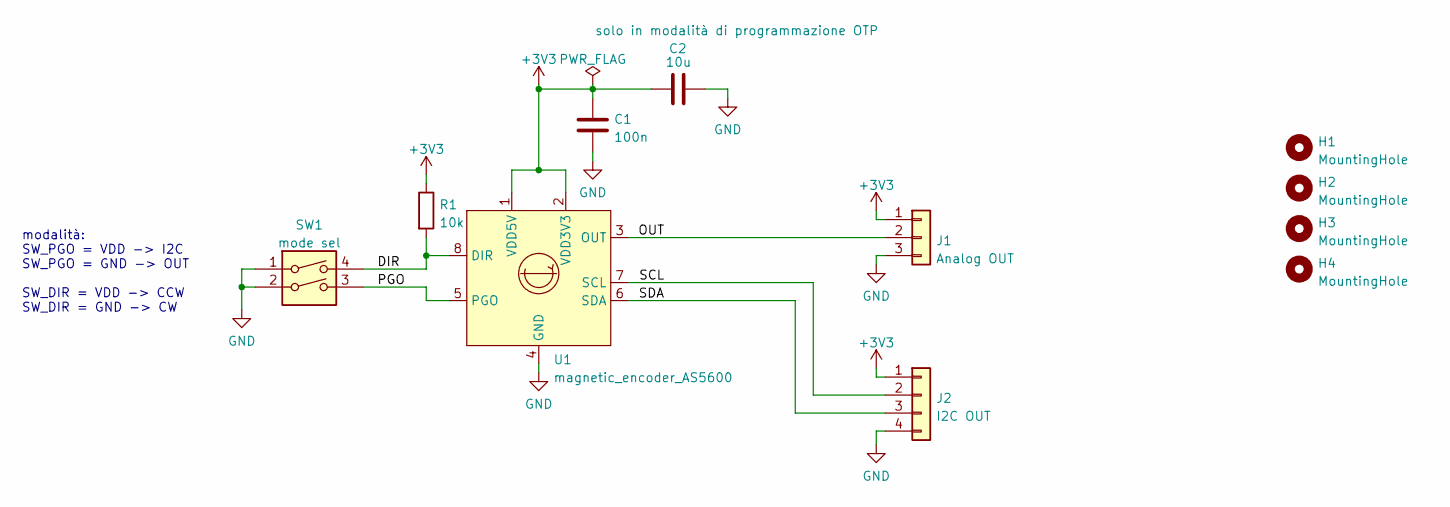
[picture p65: schematic ENCODER.kicad_sch, Scheda encoder AS5600]

Parts:
C1: 100n; C_0603_1608Metric
C2: 10u; PinSocket_1x02_P2.54mm_Vertical
H1, H2, H3, H4: MountingHole; MountingHole_3.2mm_M3_Pad_Via
J1: Analog OUT; JST_XH_B3B-XH-A_1x03_P2.50mm_Vertical
J2: I2C OUT; JST_XH_B4B-XH-A_1x04_P2.50mm_Vertical
R1: 10k; R_0603_1608Metric
SW1: mode sel; SW_DIP_SPSTx02_Slide_9.78x7.26mm_W7.62mm_P2.54mm; farnell 2864305
U1: magnetic_encoder_AS5600; SOIC-8_3.9x4.9mm_P1.27mm

Connections:
+3V3: C1.1, C2.1, J1.1, J2.1, R1.1, U1.1 (VDD5V), U1.2 (VDD3V3)
/DIR: R1.2, SW1.4, U1.8 (DIR)
/OUT: J1.2, U1.3 (OUT)
/PGO: SW1.3, U1.5 (PGO)
/SCL: J2.2, U1.7 (SCL)
/SDA: J2.3, U1.6 (SDA)
GND: C1.2, C2.2, J1.3, J2.4, SW1.1, SW1.2, U1.4 (GND)

Notes on the sheet:
modalità: SW_PGO = VDD -> I2C SW_PGO = GND -> OUT SW_DIR = VDD -> CCW SW_DIR = GND -> CW

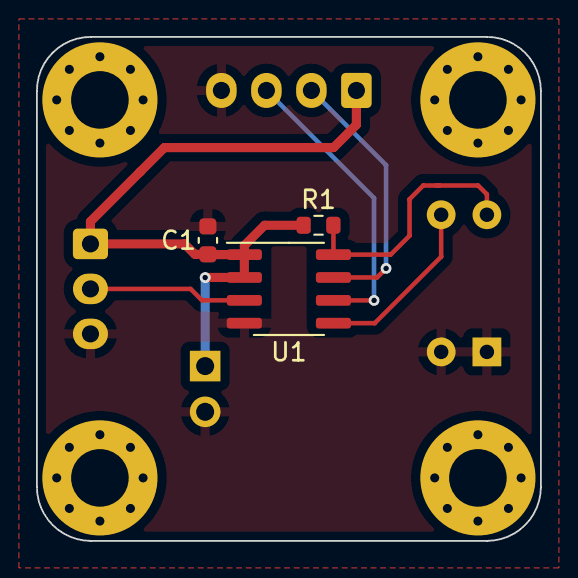
[picture p66: board ENCODER.kicad_pcb from above]

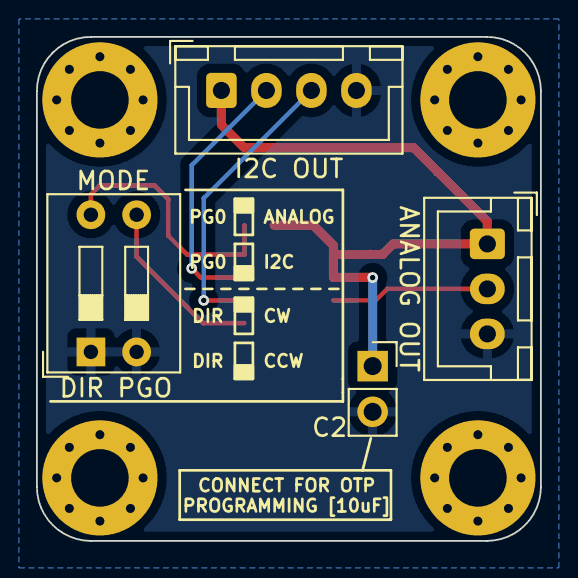
[picture p67: board ENCODER.kicad_pcb from below]

Board: 2 copper layers, 28.0 x 28.0 mm, 11 parts (4 on the bottom side), 7 nets.
