Eduzyolo/PSE_project/(commit log)

2023-03-22 Fatto lo schema base
    Fatto lo schema base:
    - rp2040
    - buck
    - usb mini
    - flash...
    [scheda PSE.kicad_pcb, scheda PSE.kicad_sch]
2023-03-23 added pico examples as subomdule
2023-03-23 moved some files
    [scheda PSE.kicad_pcb, scheda PSE.kicad_sch]
2023-03-23 added pi pico examples with correct submodule path
2023-03-23 added CASE folder
2023-03-25 aggiunto GPS, LED_alive, Buzzer, RGB_WS2812B
    [Buzzer.kicad_sch, Led_RGB_WS2812B.kicad_sch, SAM-M8Q.kicad_sch, scheda PSE.kicad_sch]
2023-03-28 Add files via upload
    aggiunto display, accelerometro, sensore temp
    [scheda PSE.kicad_sch]
2023-03-28 Sistemato tutto lo schematico con fogli gerarchici
    Sistemato lo schematico, ordinato tutti i componenti nei vari fogli gerarchici.
    aggiunto ldo e sistemato il buck converter. aggiunti anche i terminali a vite per le connessioni esterne
    [Buzzer.kicad_sch, Interfaccia_utente.kicad_sch, Led_RGB_WS2812B.kicad_sch, SAM-M8Q.kicad_sch, alimentazione.kicad_sch, rp2040.kicad_sch, scheda PSE.kicad_sch, sensori.kicad_sch]
2023-03-28 aggiunta memoria EEPROM a schematico
    [AT24C256_EEPROM.kicad_sch, scheda PSE.kicad_sch]
2023-03-29 sistemato tutto, e aggiunti i footprint da modificare
    sistemato tutto, aggiunto e modificato i footprint.
    Manca solo aggiungere i restanti footprint (praticamente solo dei componenti comuni)
    [AT24C256_EEPROM.kicad_sch, Interfaccia_utente.kicad_sch, Led_RGB_WS2812B.kicad_sch, alimentazione.kicad_sch, rp2040.kicad_sch, scheda PSE.kicad_sch, sensori.kicad_sch]
2023-03-29 fatto schema e pcb scheda encoder
    [ENCODER.kicad_pcb, ENCODER.kicad_sch]
2023-03-30 prova librerie
    [DG126-5.0-02P-12-00AH.STEP, DG126-5.0-03P-12-00AH.STEP, DG126-5.0-04P-12-00AH.STEP, DG126-5.0-05P-12-00AH.STEP, DG126-5.0-06P-12-00AH.STEP, DG126-5.0-07P-12-00AH.STEP, GPS_sam-m8q.STEP, HF49FD.IGS]
2023-03-30 caricati anche i modelli 3d
    [TEMT6000X01.stp]
2023-03-30 removed pico test
2023-03-30 Aggiunti QUASI tutti i footprint
    aggiunti quasi tutti i footprint dei componenti
    [Interfaccia_utente.kicad_sch, Led_RGB_WS2812B.kicad_sch, alimentazione.kicad_sch, rp2040.kicad_sch, scheda PSE.kicad_sch, sensori.kicad_sch]
2023-04-01 Aggiunto Modello 3d case ENCODER
    [Assieme.SLDASM, ENCODER.kicad_pcb, ENCODER.step, PCB encoder.SLDPRT, case encoder.SLDPRT, magnete.SLDPRT, perno sotto.SLDPRT, ruota.SLDPRT]
2023-04-04 iniziato il layout, posizionati componenti principali
    incominciato il posizionamento dei componenti nel layout. Sono stati posizionati i componenti principali come led RGB, GPS, schermo, pulsanti vari, buzzer
    [Assieme.SLDASM, ENCODER.kicad_pcb, ENCODER.kicad_sch, IND_IHLP-1212BZ_VIS.step, Led_RGB_WS2812B.kicad_sch, Pantalla OLED 0.96'' 128x64.stp, RND 455-00210_3D.SLDPRT, RND 455-00210_3D.STEP]
2023-04-05 Posizionati tutti i componenti
    Posizionati tutti i componenti sulla scheda
    [Interfaccia_utente.kicad_sch, alimentazione.kicad_sch, rp2040.kicad_sch, scheda PSE.kicad_pcb, scheda PSE.kicad_sch, sensori.kicad_sch]
2023-04-13 iniziato lo broglio. Prima di continuare modificare pin schema
    iniziato lo sbroglio della scheda, prima di continuare bisogna sistemare i pin che siano concordi con quelli degli altro (ovvero sistemarli come da tabella su telegram)
    [ENCODER-B_Cu.gbr, ENCODER-B_Mask.gbr, ENCODER-B_Paste.gbr, ENCODER-B_Silkscreen.gbr, ENCODER-Edge_Cuts.gbr, ENCODER-F_Cu.gbr, ENCODER-F_Mask.gbr, ENCODER-F_Paste.gbr]
2023-04-14 sistemato buzzer, e continuato lo sbroglio
    sistemato il buzzer con un altro footprint e ho continuato lo sbroglio.
    Teoricamente manca solo collegare i collegamenti tra le gpio del rp2040 e il resto dei componenti
    [Interfaccia_utente.kicad_sch, MLT-8530.step, alimentazione.kicad_sch, scheda PSE.kicad_pcb, scheda PSE.kicad_sch, sensori.kicad_sch]
2023-04-14 modificato pin 2,3,14,15,16,17,18,27,28,29,30,31,32
    [rp2040.kicad_sch, scheda PSE.kicad_sch, sensori.kicad_sch]
2023-04-14 finito lo sbroglio (magari da ricontrollare)
    finito lo sbroglio, controllato già io ma meglio ridare una controllata.
    Da sistemare tutta la serigrafia
    [rp2040.kicad_sch, scheda PSE.kicad_pcb, scheda PSE.kicad_sch, sensori.kicad_sch]
2023-04-15 finito tutto
    sistemati tutti i nomi dei componenti e inserite tutte le grafiche necessarie
    [scheda PSE.kicad_pcb]
2023-04-15 sistemato nomi periferiche esterne uart e i2c
    [scheda PSE.kicad_pcb]
2023-04-17 abbellita un po' la scheda
    sostituite alcune scritte sulla sceda
    [scheda PSE.kicad_pcb]
2023-04-17 cambiati i pulsanti in smd
    se servono gli altri pulsanti usare la versione precedente
    [Interfaccia_utente.kicad_sch, alimentazione.kicad_sch, rp2040.kicad_sch, scheda PSE.kicad_pcb, scheda PSE.kicad_sch]
2023-04-17 Aggiunte tutte le cose richieste dal prof
    Aggiunte tutte le cose richieste dal prof:
    wifi
    servo
    uscita led
    MANCA DA METERE IL SOLDER MASK SUI PAD NON USATI DEL GPS
    [AKSCT-G-BLACK.stp, Assieme.SLDASM, ESP8266-ESP01.SLDASM, ESP8266-ESP01.STEP, Interfaccia_utente.kicad_sch, Led_RGB_WS2812B.kicad_sch, alimentazione.kicad_sch, magnete.SLDPRT]
2023-04-18 Sistemate un po'di cose
    aggiuno fori display e terzo servo e sistemate le serigrafie
    [ENCODER-B_Cu.gbr, ENCODER-B_Mask.gbr, ENCODER-B_Paste.gbr, ENCODER-B_Silkscreen.gbr, ENCODER-Edge_Cuts.gbr, ENCODER-F_Cu.gbr, ENCODER-F_Mask.gbr, ENCODER-F_Paste.gbr]
2023-04-19 Aggiunto mosfet uscita corrente usb
    Ultima modifica prima della revisone generale.
    aggiunto un mosfet P per l'attivazione dell'uscita della tensione alla usb in caso di master
    [alimentazione.kicad_sch, rp2040.kicad_sch, scheda PSE.kicad_pcb, scheda PSE.kicad_sch]
2023-04-20 Versione definitiva inviata ai prof
    Sistemato tutto e inviato il tutto ai prof
    [AT24C256_EEPROM.kicad_sch, BOM.xlsx, Led_RGB_WS2812B.kicad_sch, alimentazione.kicad_sch, rp2040.kicad_sch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]
2023-05-04 added accelerometer test
2023-05-09 last version arduino
2023-05-13 aggiunto file modello 3d encoder
    aggiunte istruzioni e materiali necessari sul file README
    [Assieme.3MF, Assieme.SLDASM, RND 455-00210_3D.SLDPRT, RND 455-00210_3D.STEP, case encoder.SLDPRT, case grande PSE.dxf, encoder per stampa 3d.stl, magnete.SLDPRT]
2023-05-20 added test code for encoder
2023-05-21 test temperature
2023-05-21 added buttons test
2023-05-21 fixes and added constans
    [Accelerometer.h, Buzzer.h, Constants.h, Eeprom_board.h, Encoder.h, GPS.h, Led.h, Oled.h]
2023-05-22 updated encoder code
2023-06-15 creato case scheda
    creato case scheda e fatto qualche render
    [Assieme.3MF, Assieme.SLDASM, RND 455-00210_3D.SLDPRT, RND 455-00210_3D.STEP, attacco gopro senza vite.SLDPRT, case encoder.SLDPRT, case grande PSE.dxf, case scheda PSE.SLDPRT]
2023-06-18 finito il case e aggiunti file per la stampa 3d
    [Assieme.SLDASM, attacco gopro senza vite.SLDPRT, botton 2.0 reset & boot.SLDPRT, botton 2.0.SLDPRT, cappuccio bottone.SLDPRT, case encoder.SLDPRT, case scheda PSE.SLDPRT, coperchio.SLDPRT]
2023-06-18 sistemato qualche file per la stampa 3d
    [coperchio.SLDPRT, scheda PSE - bottoni 2.0 reset & boot.STL, scheda PSE - bottoni 2.0.STL, scheda PSE - case scheda PSE.STL, scheda PSE - coperchio.STL]
2023-06-22 modificato qualche modello 3d del case
    [Assieme.SLDASM, botton 2.0 reset & boot.SLDPRT, botton 2.0.SLDPRT, coperchio.SLDPRT]
